rh1tech/echo_hdmi/3D/HDMI connector.STEP

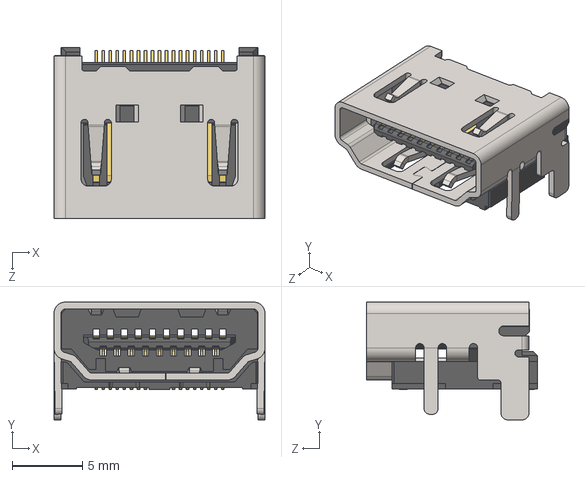
[picture p1: CAD file, 2025-07-04]
3D/HDMI connector.STEP
15.0 x 8.38 x 12.1 mm
