rh1tech/echo_hdmi/3D/PICO Clone-Black .step

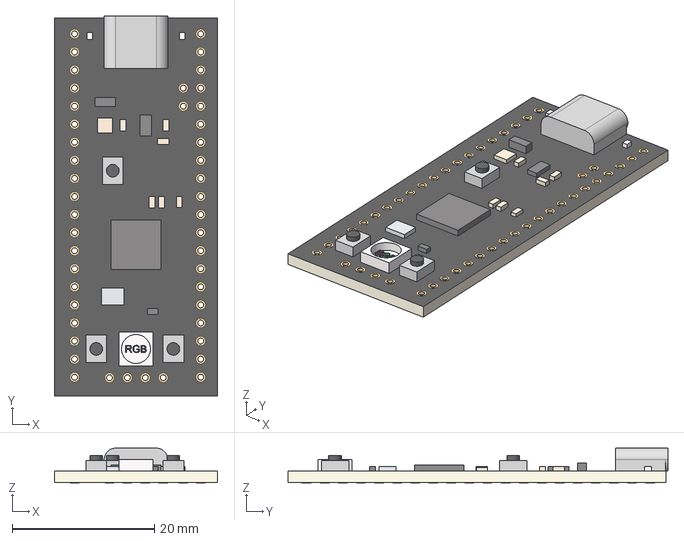
[picture p2: CAD file, 2025-07-04]
3D/PICO Clone-Black .step
22.9 x 53.3 x 4.88 mm
