rh1tech/echo_hdmi/3D/SJ1-3535NG.stp

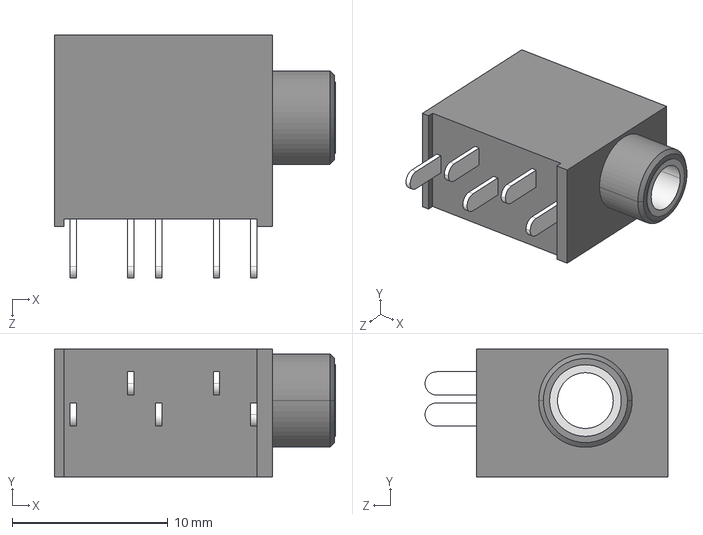
[picture p3: CAD file, 2025-07-04]
3D/SJ1-3535NG.stp
18.1 x 8.20 x 15.6 mm
