rh1tech/echo_hdmi/3D/ESP8266-12E_ESP-12E.step

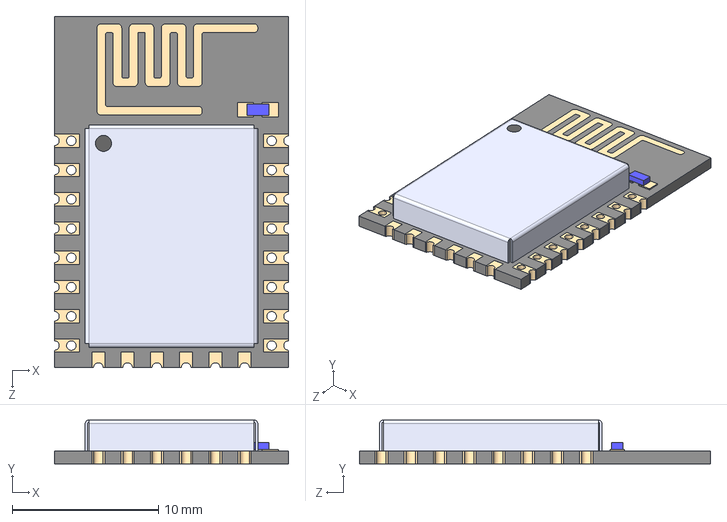
[picture p4: CAD file, 2025-07-04]
3D/ESP8266-12E_ESP-12E.step
16.0 x 3.00 x 24.0 mm
