rh1tech/echo_hdmi/3D/Mini-DIN-6P.step

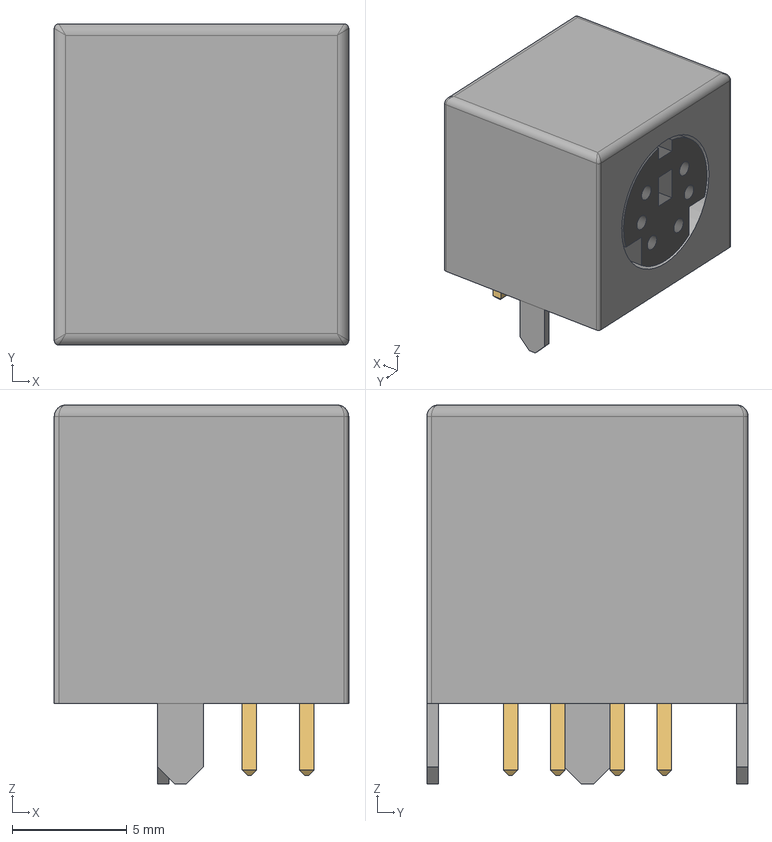
[picture p5: CAD file, 2025-07-04]
3D/Mini-DIN-6P.step
12.8 x 14.0 x 16.5 mm
