rh1tech/echo_hdmi/3D/Ts-1233_1.5.stp

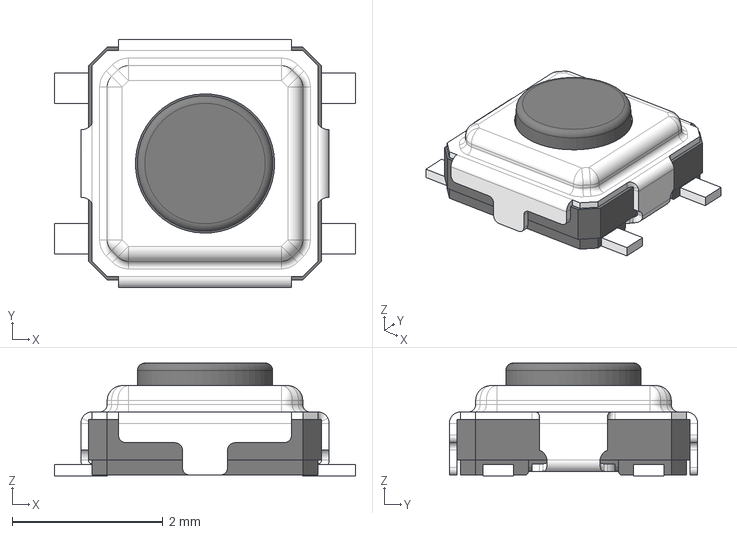
[picture p6: CAD file, 2025-07-04]
3D/Ts-1233_1.5.stp
4.00 x 3.30 x 1.50 mm
