rh1tech/echo_hdmi/3D/2520 SMD Crystal Oscillator.STEP

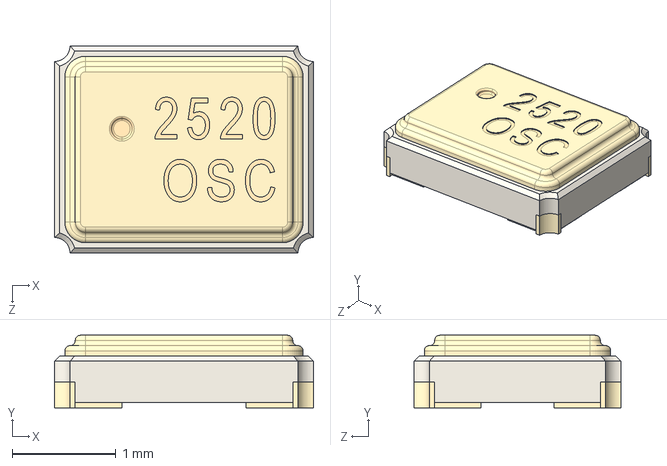
[picture p7: CAD file, 2025-07-04]
3D/2520 SMD Crystal Oscillator.STEP
2.50 x 0.7 x 2.00 mm
