rh1tech/echo_hdmi/3D/MAX232CSE+.stp

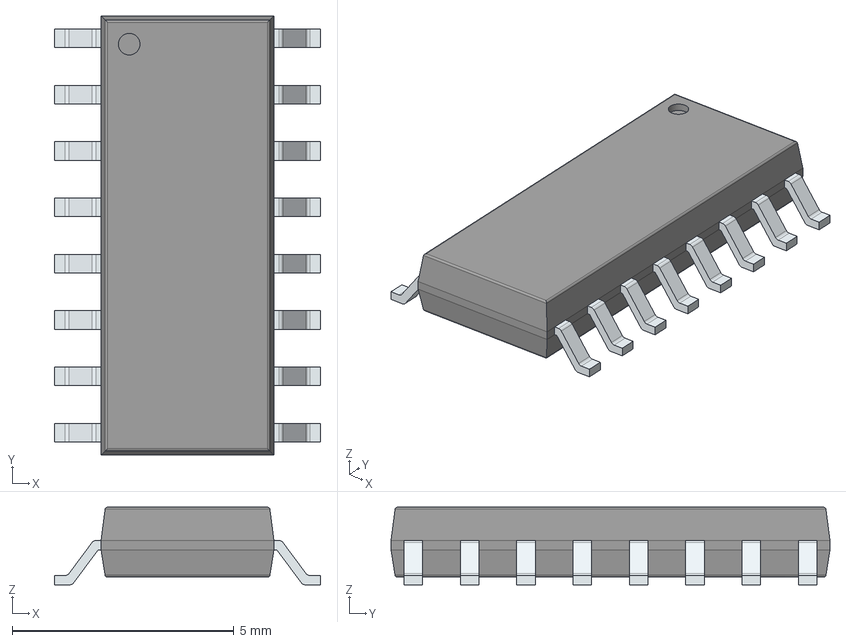
[picture p8: CAD file, 2025-07-04]
3D/MAX232CSE+.stp
6.00 x 9.90 x 1.75 mm
PinsArrayLR
