rh1tech/echo_hdmi/3D/User Library-QFN48_0_4.STEP

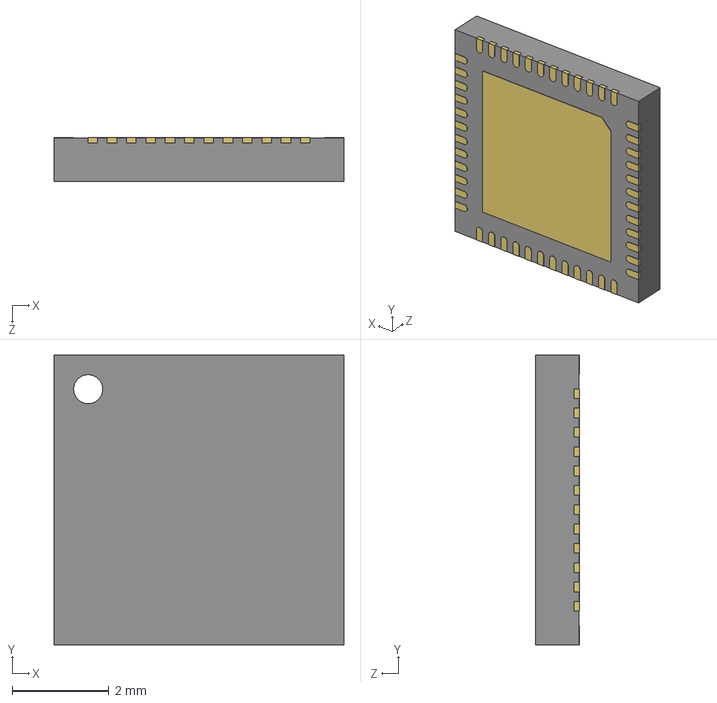
[picture p9: CAD file, 2025-07-04]
3D/User Library-QFN48_0_4.STEP
6.00 x 6.00 x 0.91 mm
