rh1tech/echo_hdmi/3D/SN74CBT3257CDR.step

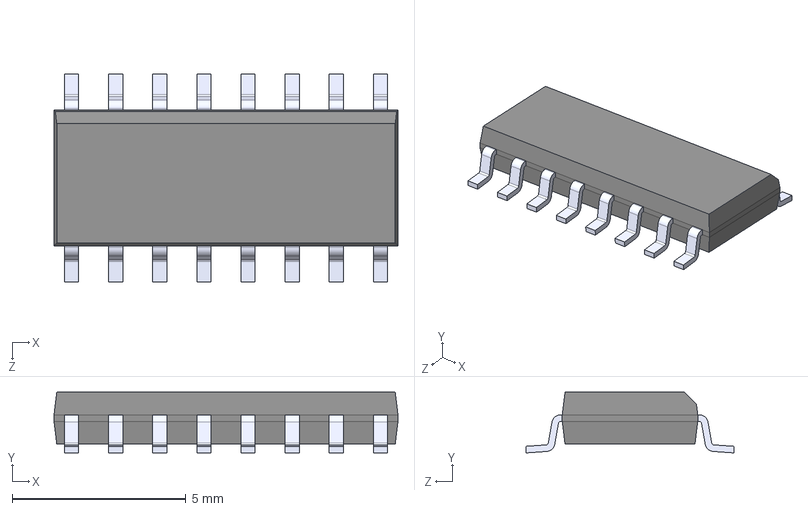
[picture p11: CAD file, 2025-07-04]
3D/SN74CBT3257CDR.step
9.90 x 1.75 x 6.00 mm
