rh1tech/echo_hdmi/3D/QFN48-5x5mm v3.step

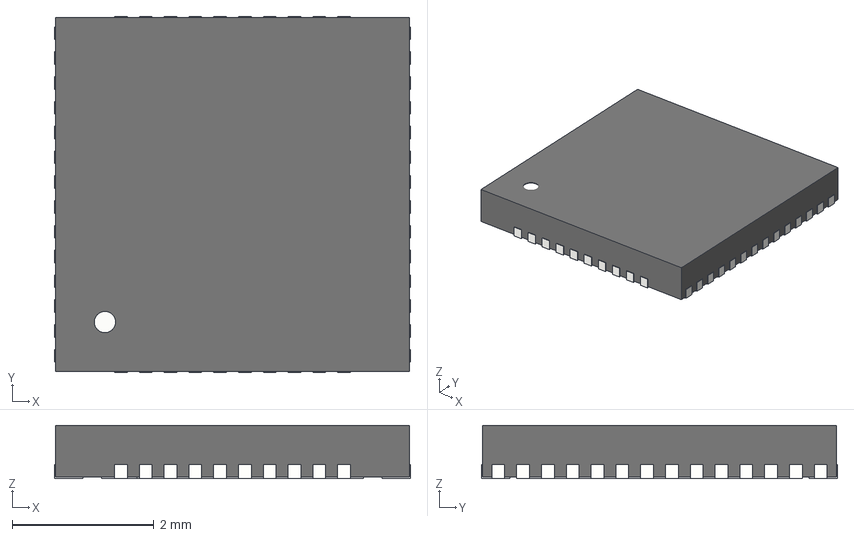
[picture p12: CAD file, 2025-07-04]
3D/QFN48-5x5mm v3.step
5.03 x 5.03 x 0.75 mm
Pads
