rh1tech/echo_hdmi/3D/raspberry pi pico with contacts.step

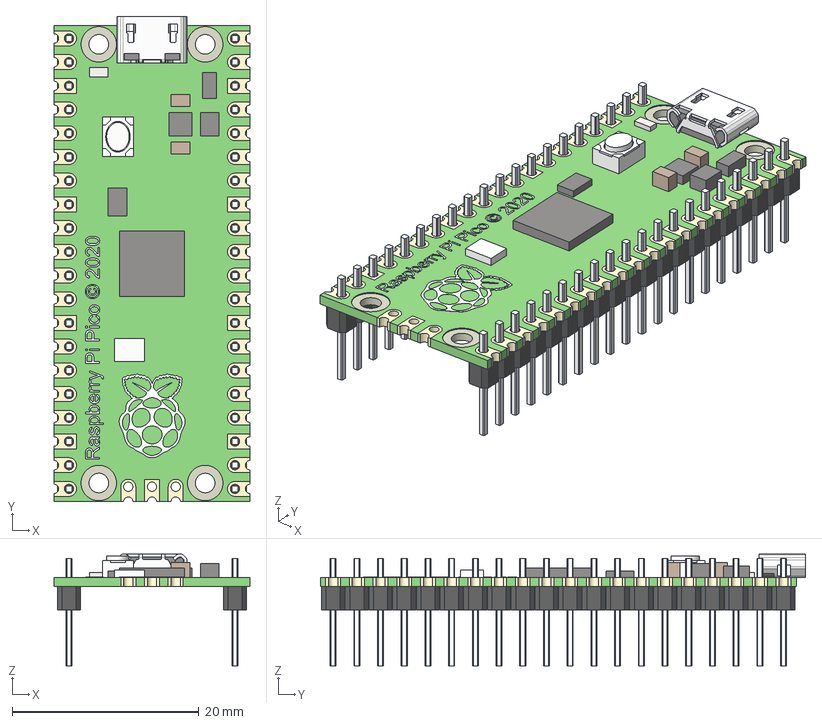
[picture p14: CAD file, 2025-07-04]
3D/raspberry pi pico with contacts.step
21.0 x 52.0 x 12.0 mm
ножка x 20
ножка v3(Mirror) x 20
