rh1tech/echo_hdmi/3D/QFN-48_7x7.step

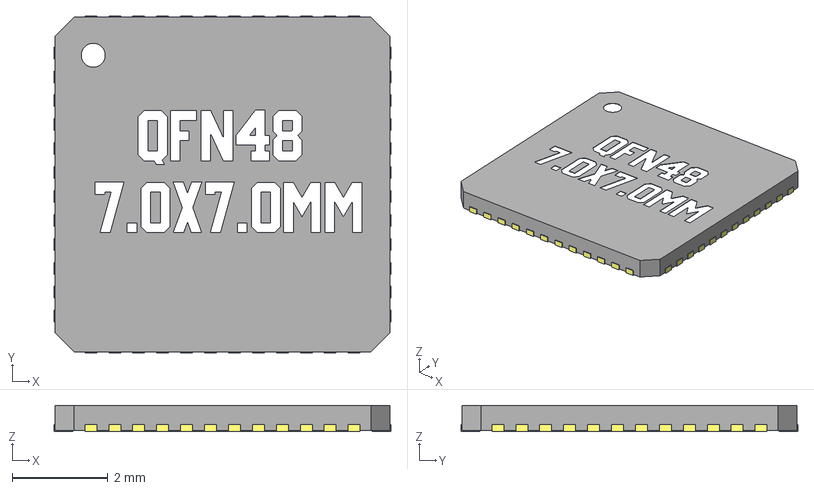
[picture p15: CAD file, 2025-07-04]
3D/QFN-48_7x7.step
7.04 x 7.04 x 0.55 mm
TxT
