rh1tech/echo_hdmi/3D/DS05-127-2-03BK-SMT-TR.step

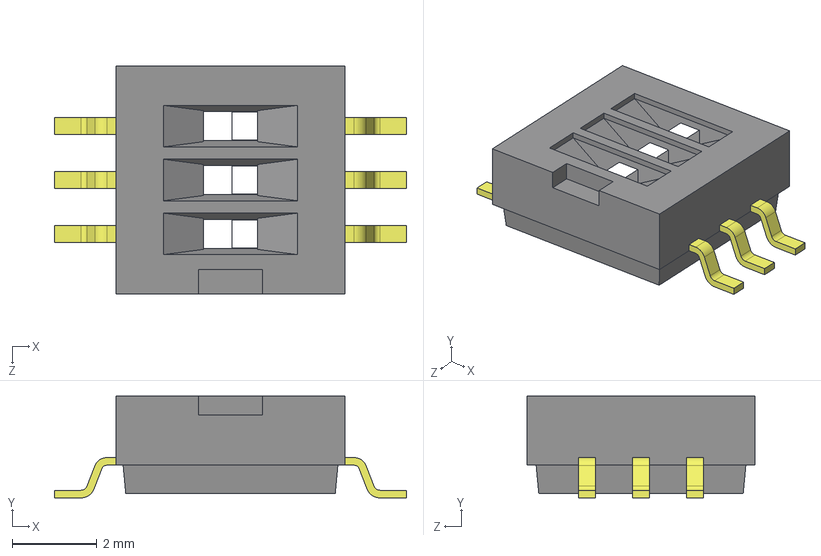
[picture p18: CAD file, 2025-07-04]
3D/DS05-127-2-03BK-SMT-TR.step
8.30 x 2.40 x 5.38 mm
