rh1tech/echo_hdmi/3D/1TS003B.step

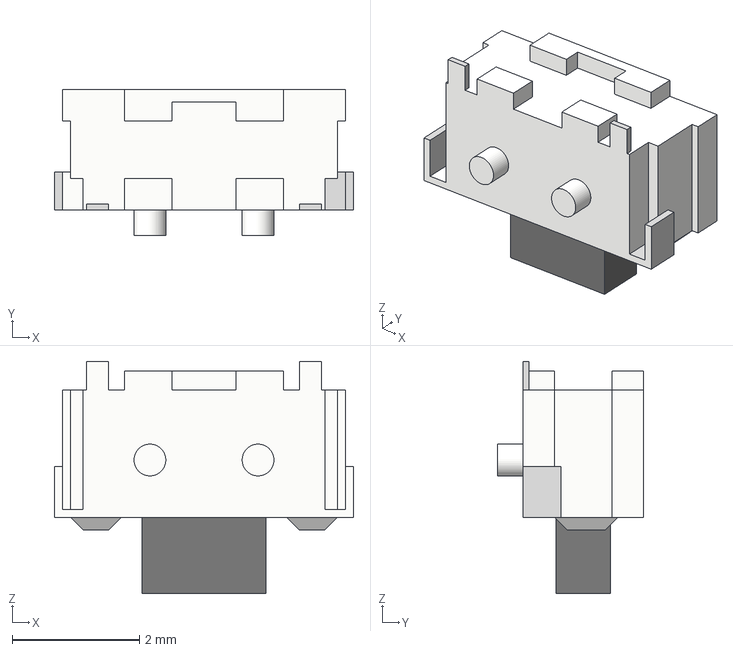
[picture p20: CAD file, 2025-07-04]
3D/1TS003B.step
4.70 x 2.30 x 3.65 mm
