rh1tech/echo_hdmi/3D/USB1035-GF-P-0-B-B.stp

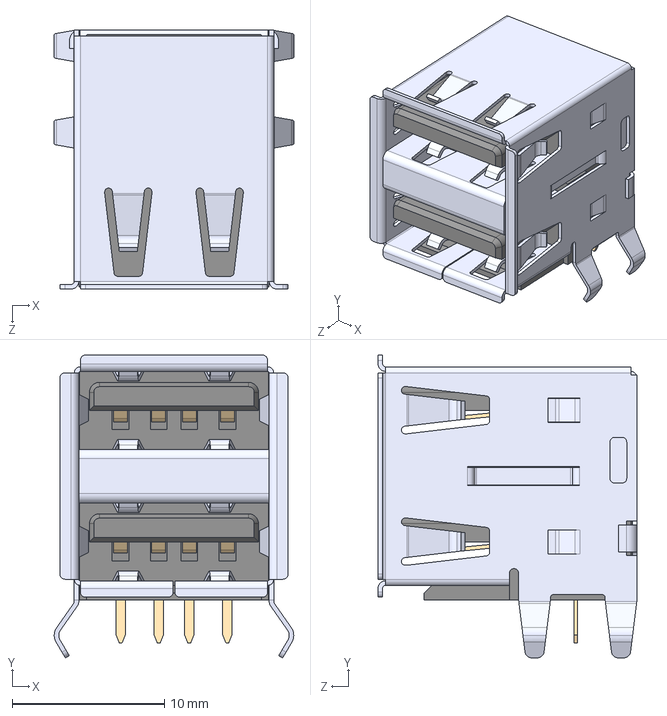
[picture p26: CAD file, 2025-07-04]
3D/USB1035-GF-P-0-B-B.stp
15.7 x 19.9 x 17.0 mm
