rh1tech/echo_hdmi/(list of files, cad)

Other CAD files:
3D/47571-0001.stp
