rh1tech/echo_hdmi/DOCS/1_00/assembly.pdf

# RP RESET P/U AUDIO OUT

# ESP RESET ESP CTRL H/B

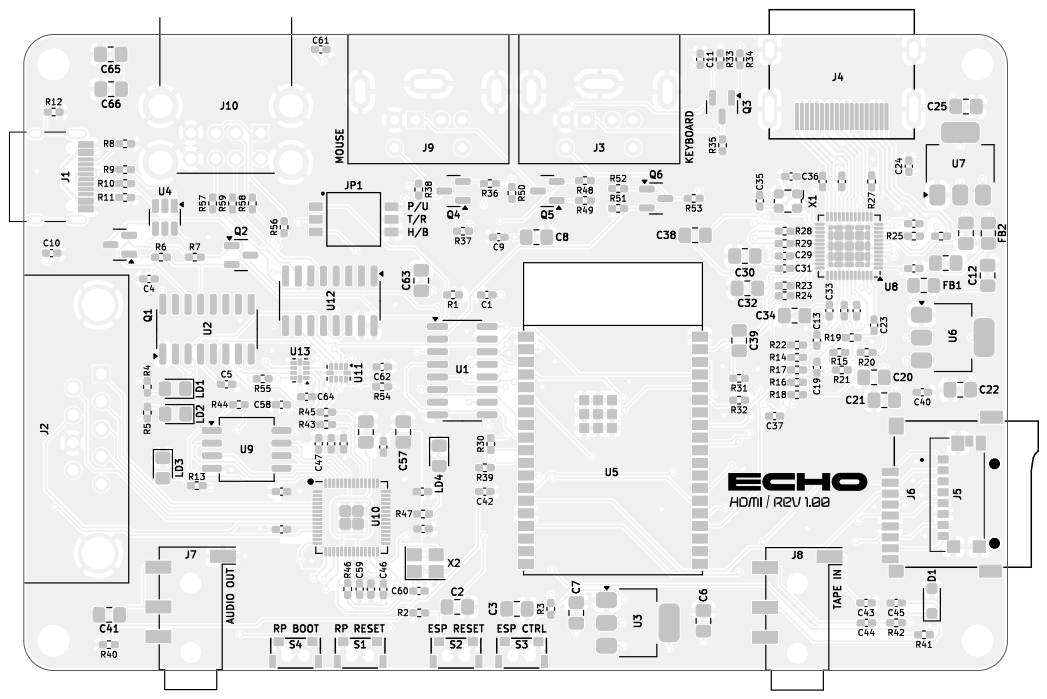
[picture p28: page 1]

https://github.com/rh1tech/echo Black And White TOP - Page 1/4

Id: /1 Title: Echo HDMI File: echo.kicad_pcb Sheet: Black And White TOP Mikhail Matveev

## TP2 TP1

JP2 1 | 2 | 3 | 4 | 5 | 6

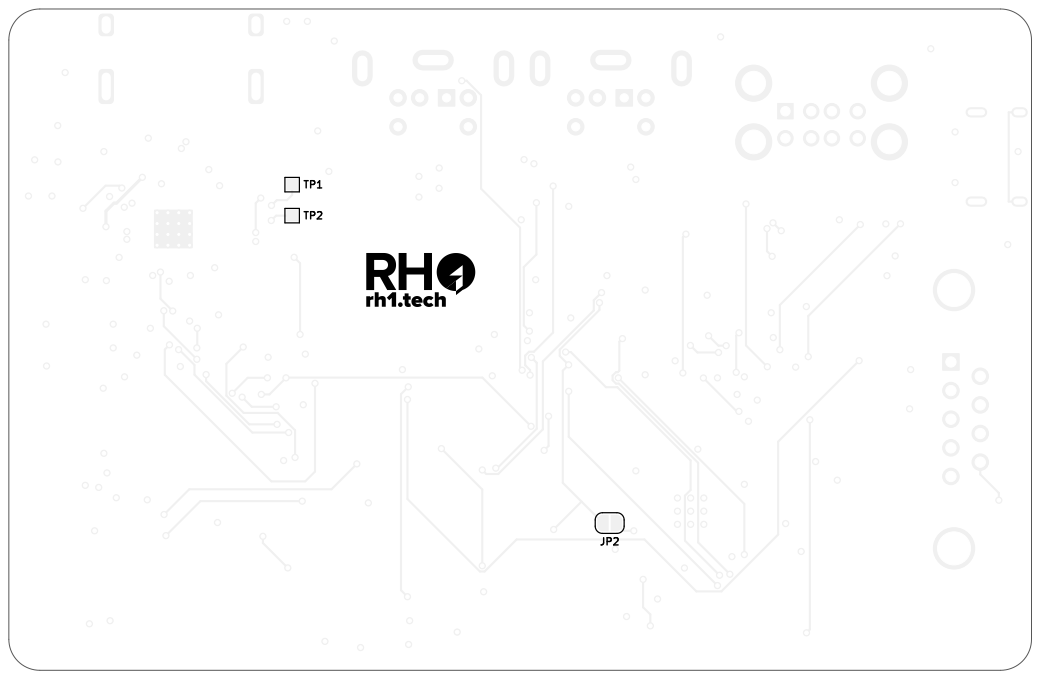
[picture p29: page 2]
D Date: 2025-07-04 KiCad; E.D.A. 9.0.0 Size: A4; Rev: 1.00; Id: /1 Title: Echo HDMI File: echo.kicad_pcb Sheet: Black; And; White; BOT Mikhail; Matveev; https://github.com/rh1tech/echo Black; BOT -; Page 2/4

A

A

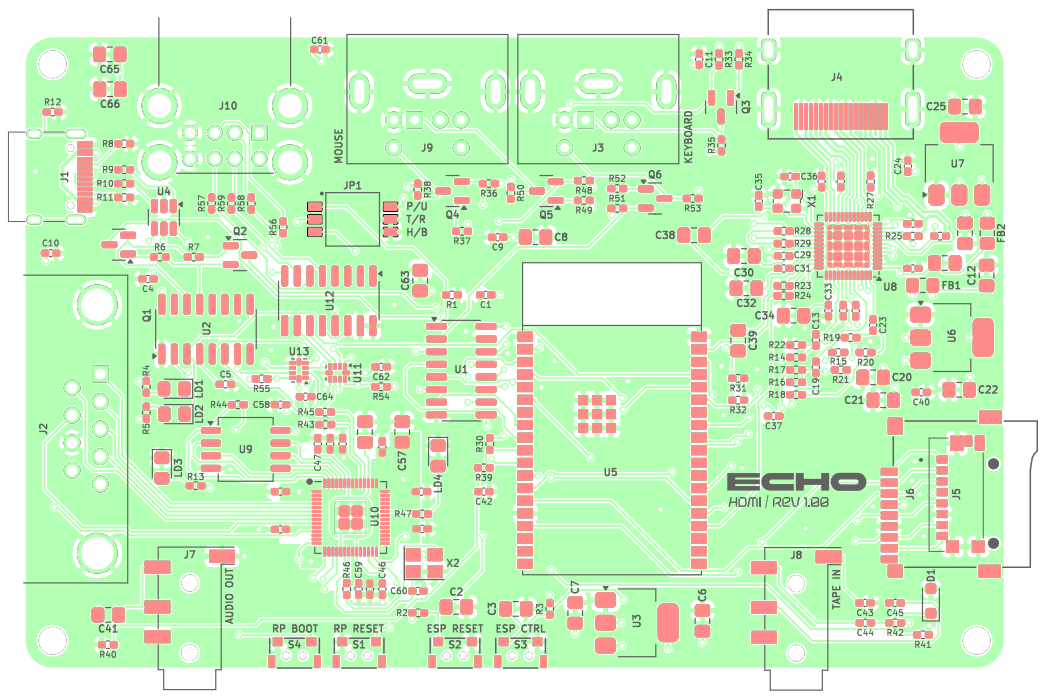
[picture p30: page 3]

ESP RESET ESP CTRL H/B

## TP2 TP1

JP2 1 | 2 | 3 | 4 | 5 | 6

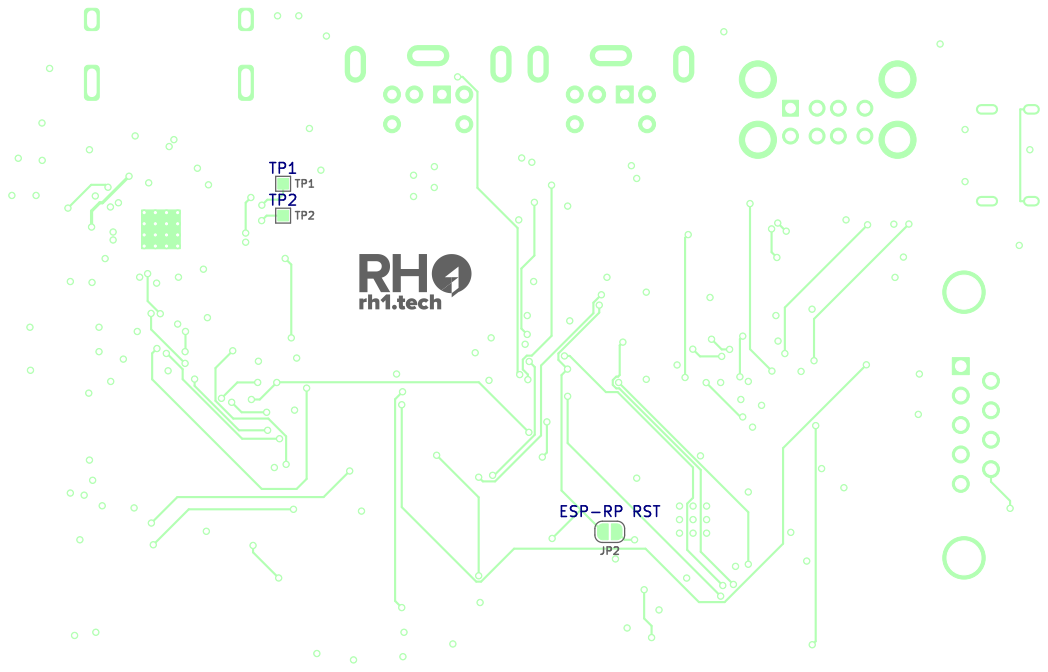
[picture p31: page 4]
D Date: 2025-07-04 KiCad; E.D.A. 9.0.0 Size: A4; Rev: 1.00; Id: /1 Title: Echo HDMI File: echo.kicad_pcb Sheet: Colored; BOT Mikhail; Matveev; https://github.com/rh1tech/echo Colored; BOT -; Page 4/4; ESP-RP RST
