rh1tech/echo_hdmi/DOCS/1_00/echo.pdf

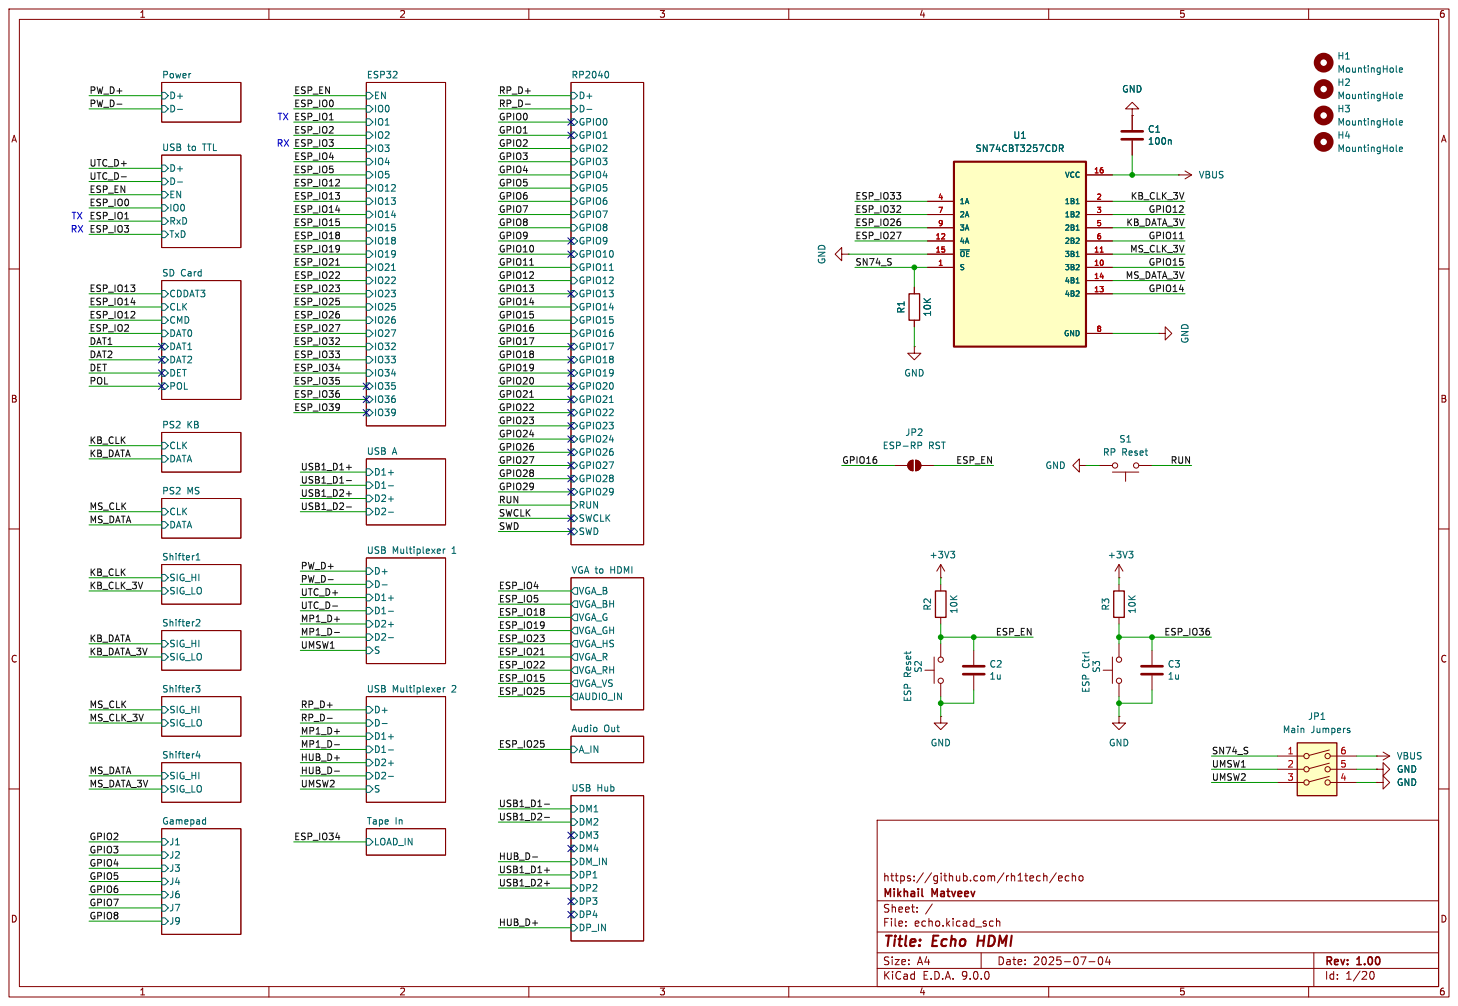
[picture p32: page 1]

TXRX RX
DAT0 DAT1 DAT2 DET POL SD Card D+D- EN

https://github.com/rh1tech/echo

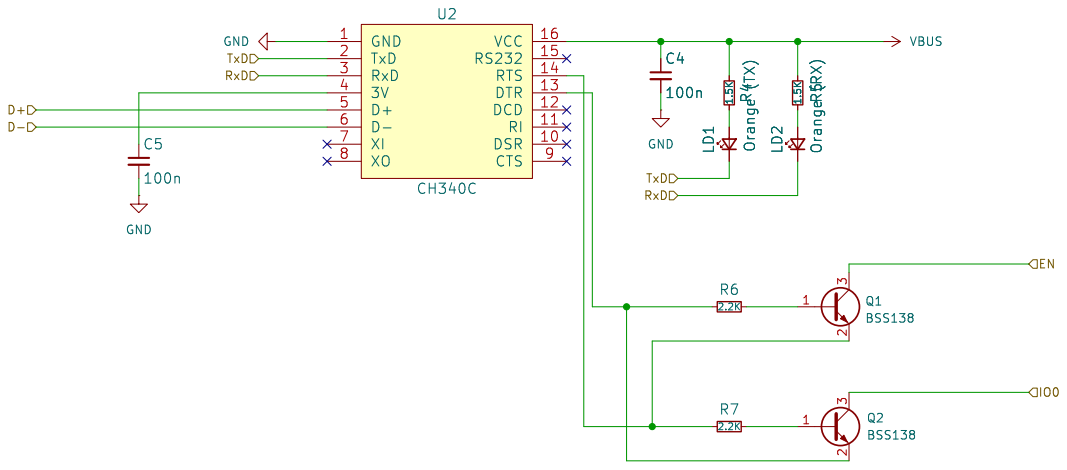
[picture p33: page 2]

https://github.com/rh1tech/echo

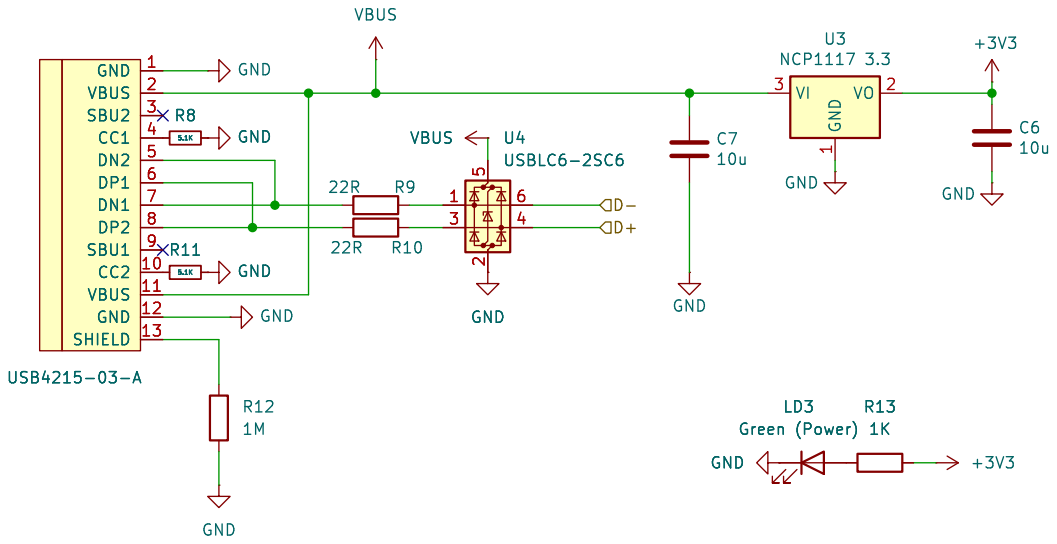
[picture p34: page 3]

1 VO 2 U3 NCP1117 3.3 GND GND 1 VBUS 2 SBU2 3 CC1 4 DN2 5 DP1 6 DN1 7 DP2 8 SBU1 9 CC2 10 VBUS 11 GND 12 SHIELD 13 USB4215-03-A GND

https://github.com/rh1tech/echo GND GND

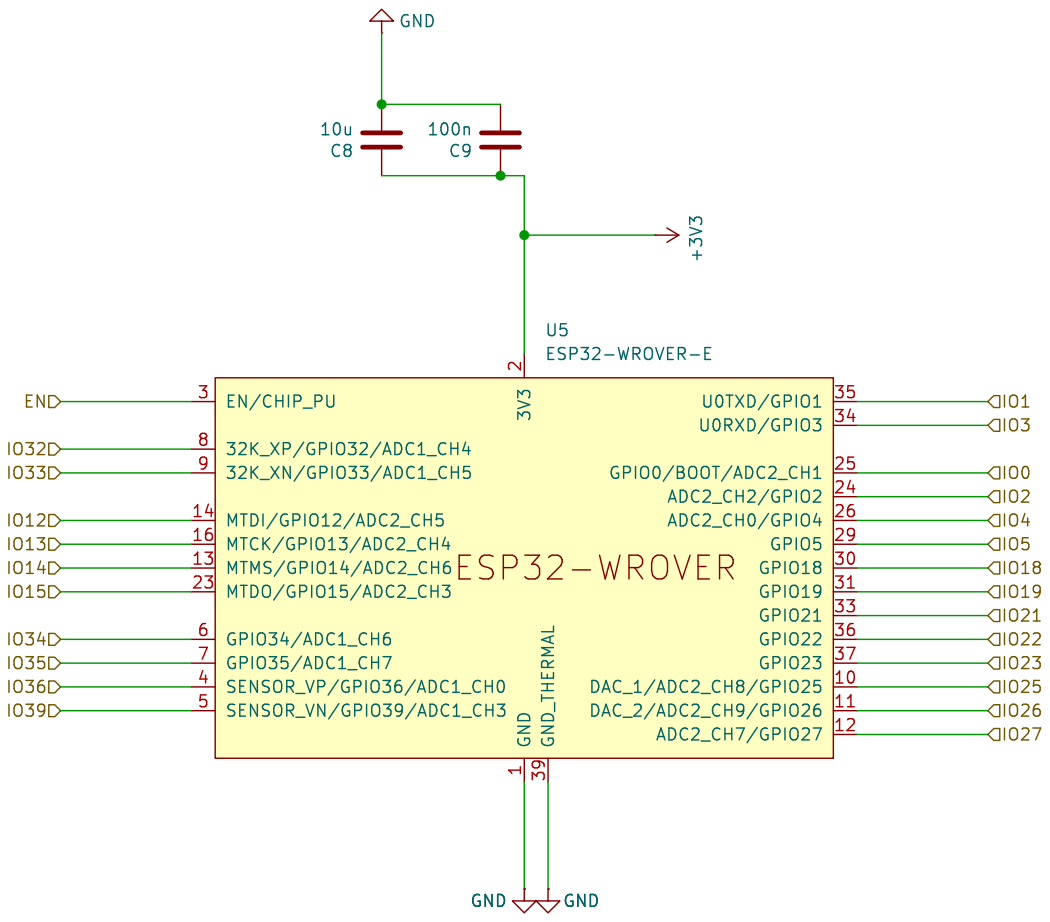
[picture p35: page 4]

1 GND_THERMAL 39 U0TXD/GPIO1 35 U0RXD/GPIO3 34 GPIO0/BOOT/ADC2_CH1 25 ADC2_CH2/GPIO2 24 ADC2_CH0/GPIO4 26 GPIO5 29 GPIO18 30 GPIO19 31 GPIO21 33 GPIO22 36 GPIO23 37 DAC_1/ADC2_CH8/GPIO25 10 DAC_2/ADC2_CH9/GPIO26 11 ADC2_CH7/GPIO27 12 U5ESP32-WROVER-E GND GND GND

https://github.com/rh1tech/echo

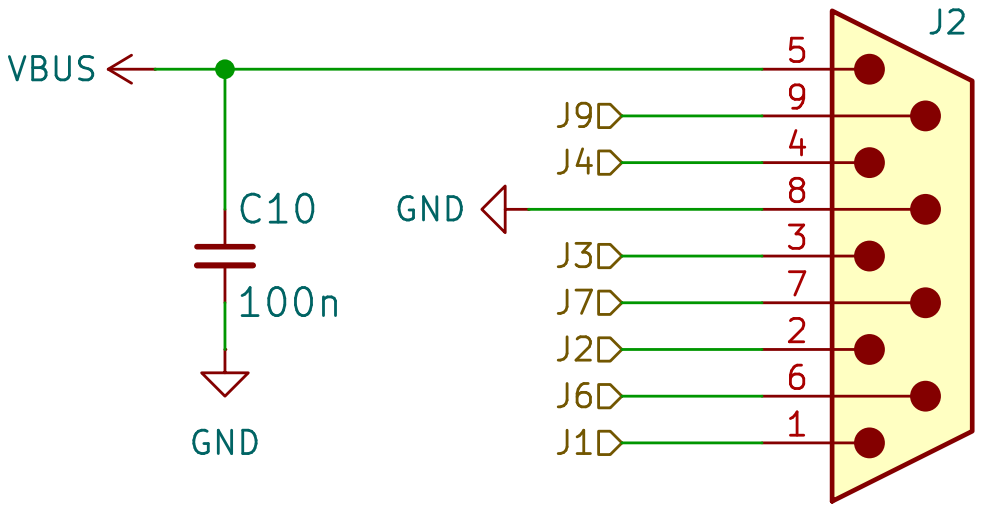
[picture p36: page 5]

https://github.com/rh1tech/echo

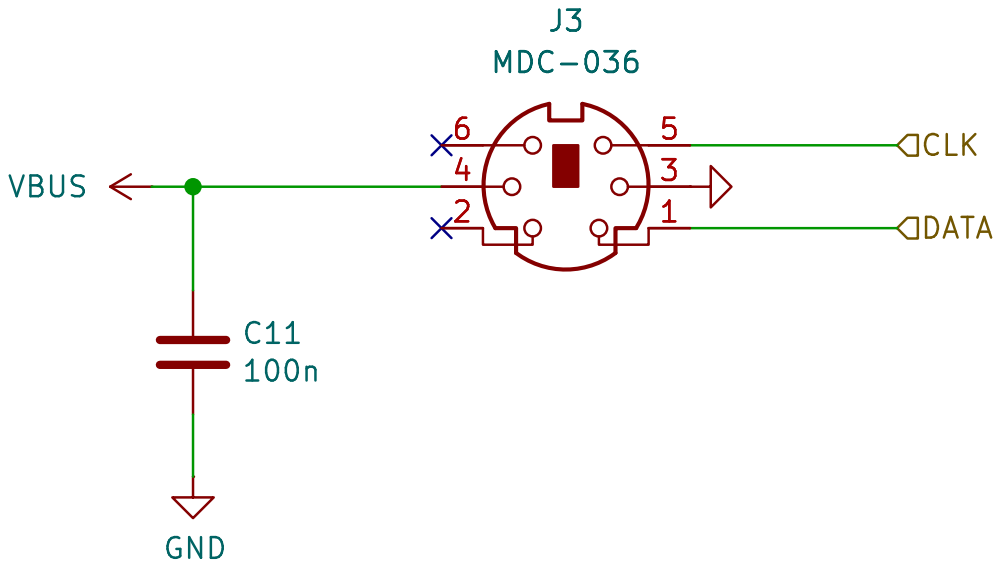
[picture p37: page 6]

https://github.com/rh1tech/echo

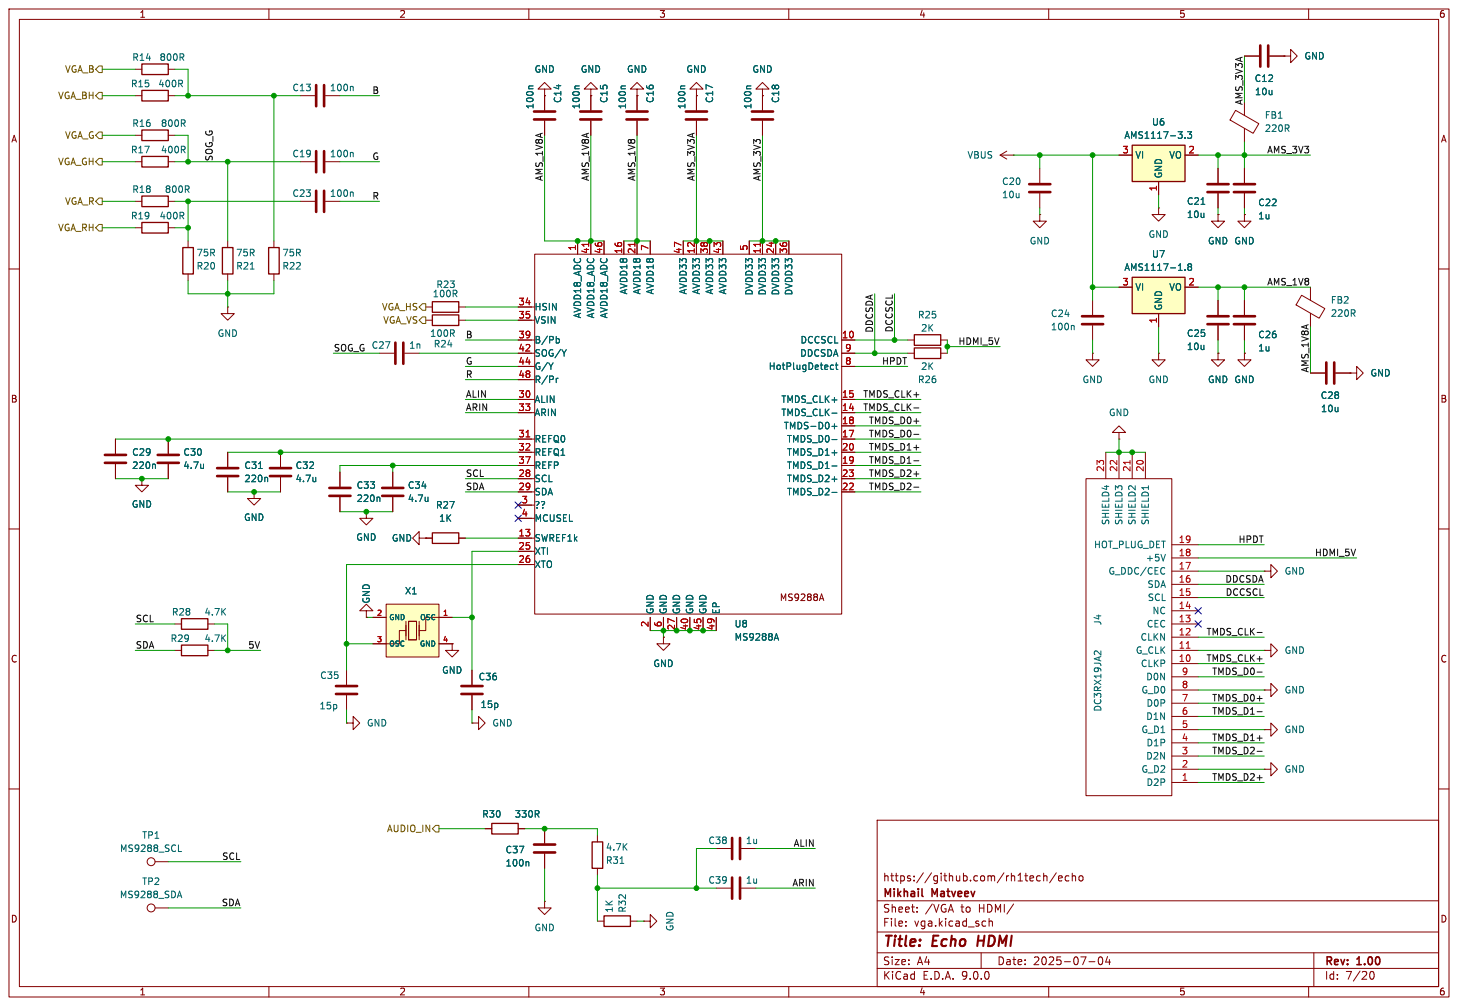
[picture p38: page 7]

5 DVDD33 11 DVDD33 24 DVDD33 36 DCCSCL 10 DDCSDA 9 HotPlugDetect 8 TMDS_CLK+ 15 TMDS_CLK- 14 TMDS-D0+ 18 TMDS_D0- 17 TMDS_D1+ 20 TMDS_D1- 19 TMDS_D2+ 23 TMDS_D2- 22 U8 MS9288A GND GND C36

5 DVDD33 11 DVDD33 24 DVDD33 36 DCCSCL 10 DDCSDA 9 HotPlugDetect 8 TMDS_CLK+ 15 TMDS_CLK- 14 TMDS-D0+ 18 TMDS_D0- 17 TMDS_D1+ 20 TMDS_D1- 19 TMDS_D2+ 23 TMDS_D2- 22 GND C36

6 GND 27 AVDD33 47 GND 40 AVDD33 12 GND 45 AVDD33 38 EP 49 AVDD33 43 DVDD33

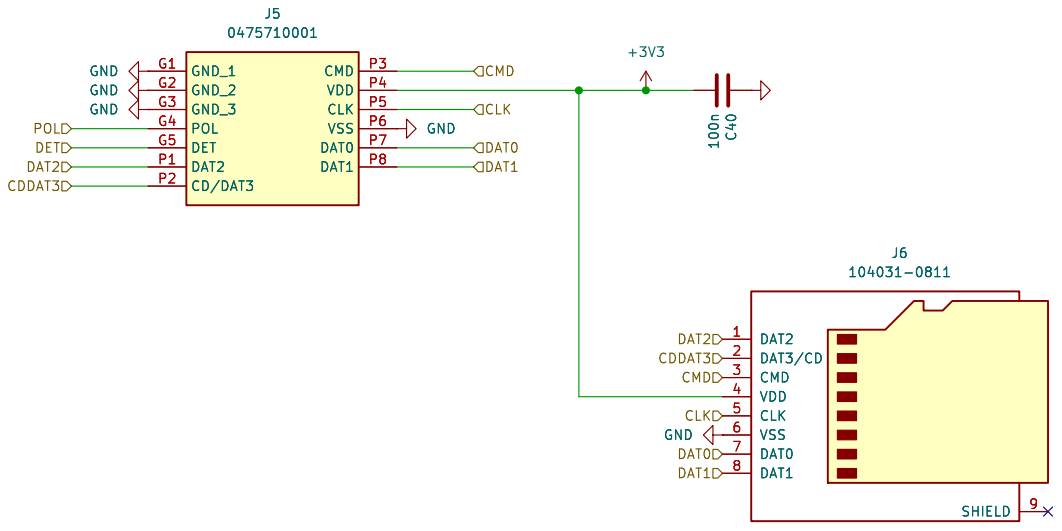
[picture p39: page 8]

https://github.com/rh1tech/echo GND

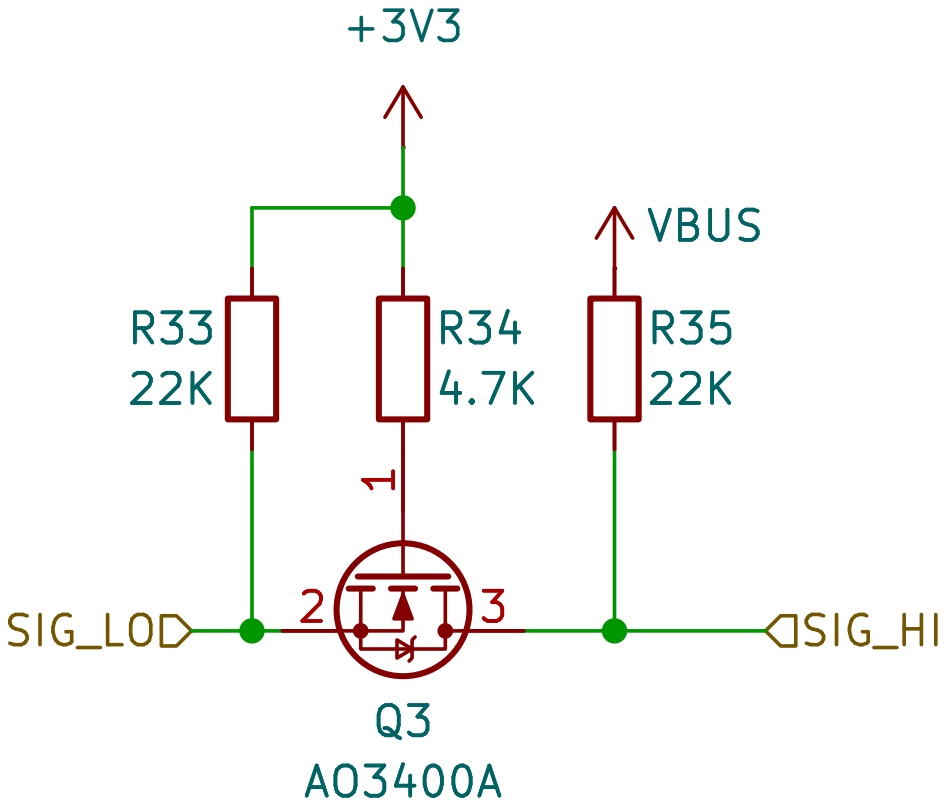
[picture p40: page 9]

https://github.com/rh1tech/echo R35

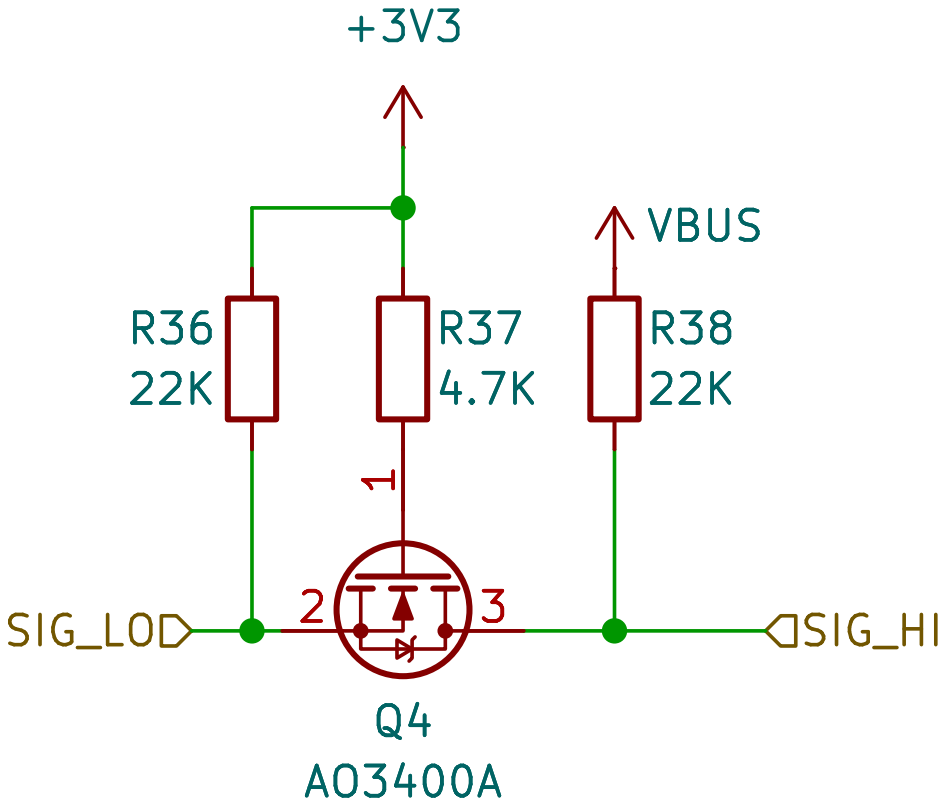
[picture p41: page 10]

https://github.com/rh1tech/echo R38

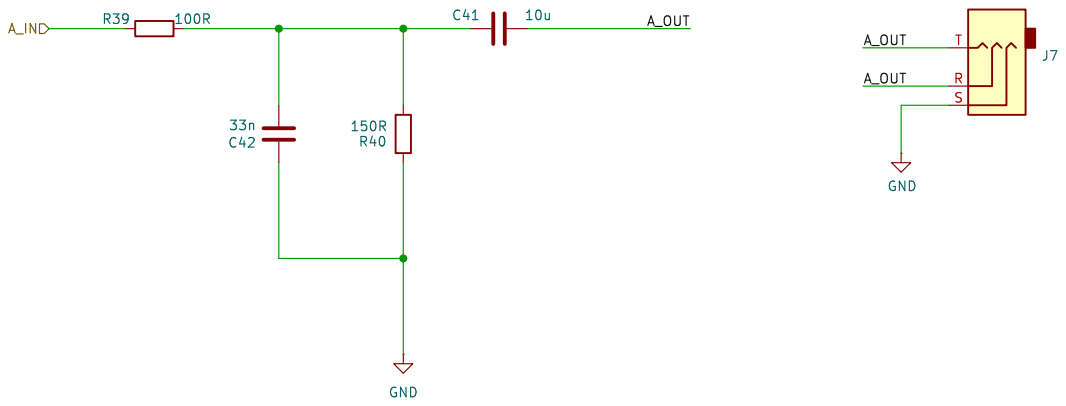
[picture p42: page 11]

https://github.com/rh1tech/echo GND

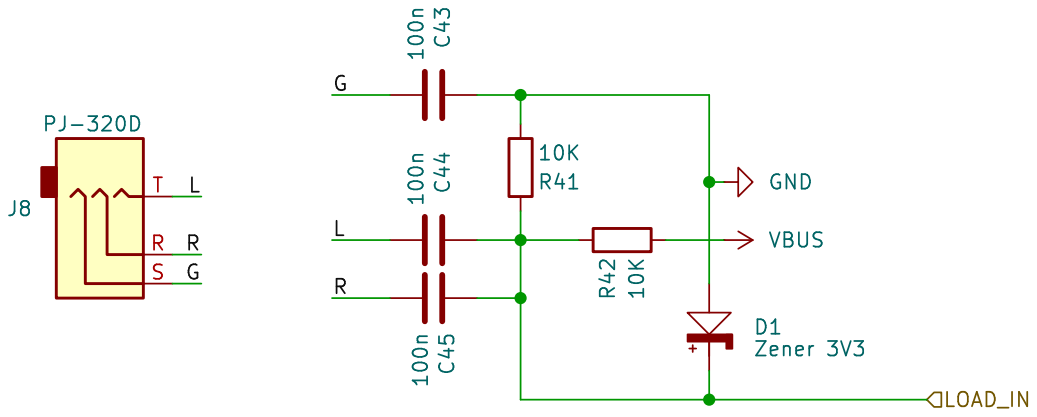
[picture p43: page 12]

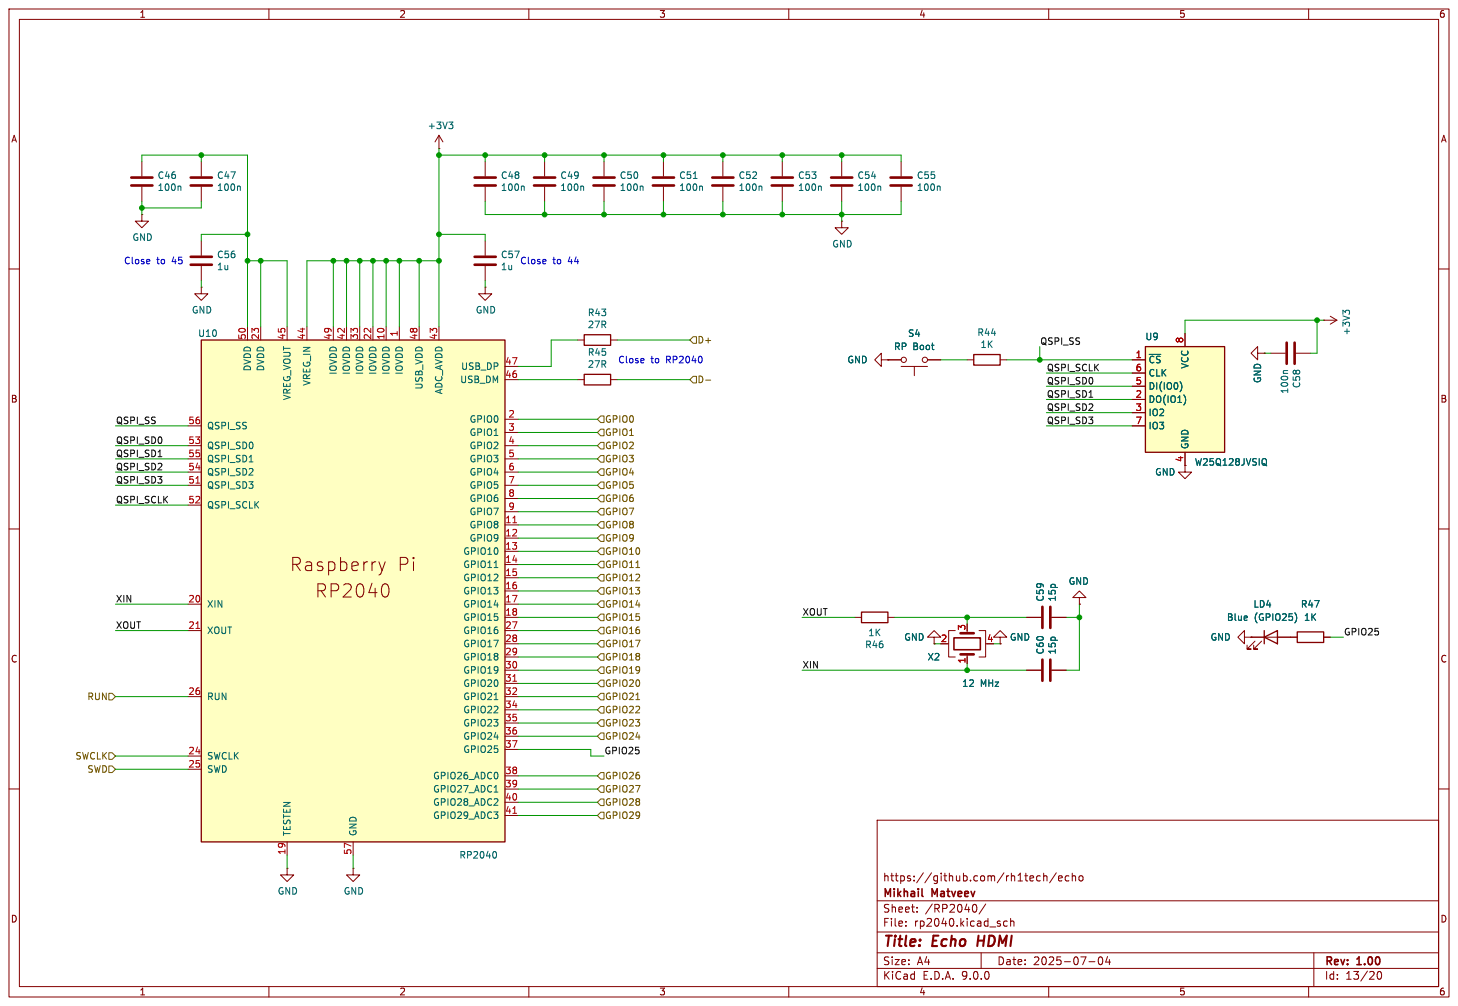
[picture p44: page 13]

https://github.com/rh1tech/echo GND

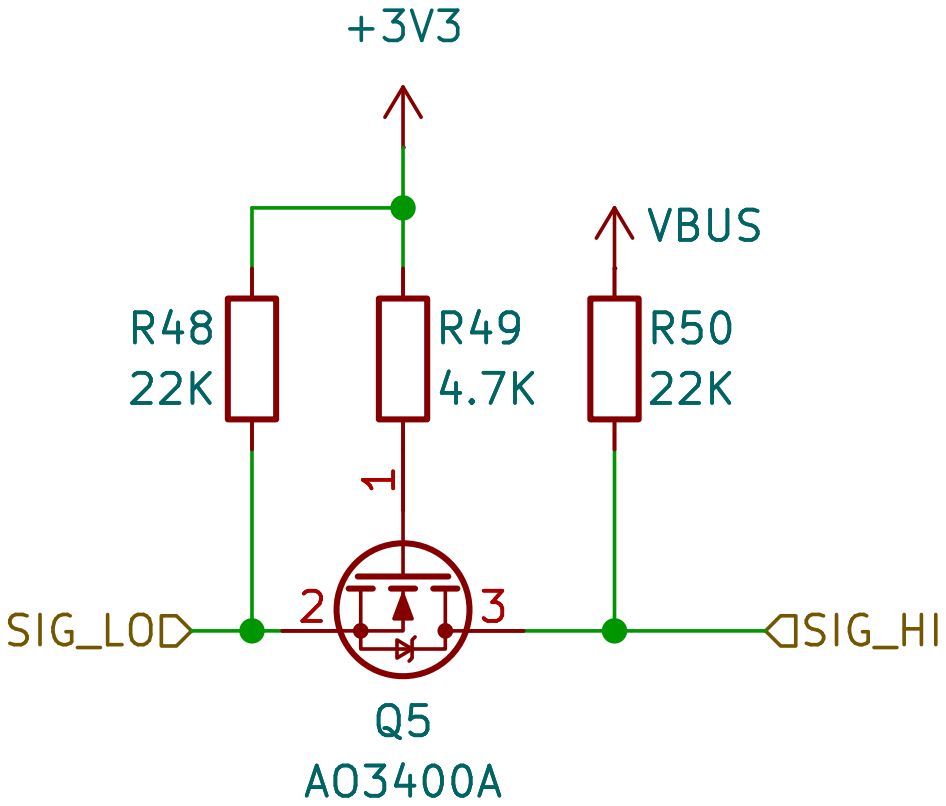
[picture p45: page 14]

https://github.com/rh1tech/echo R50

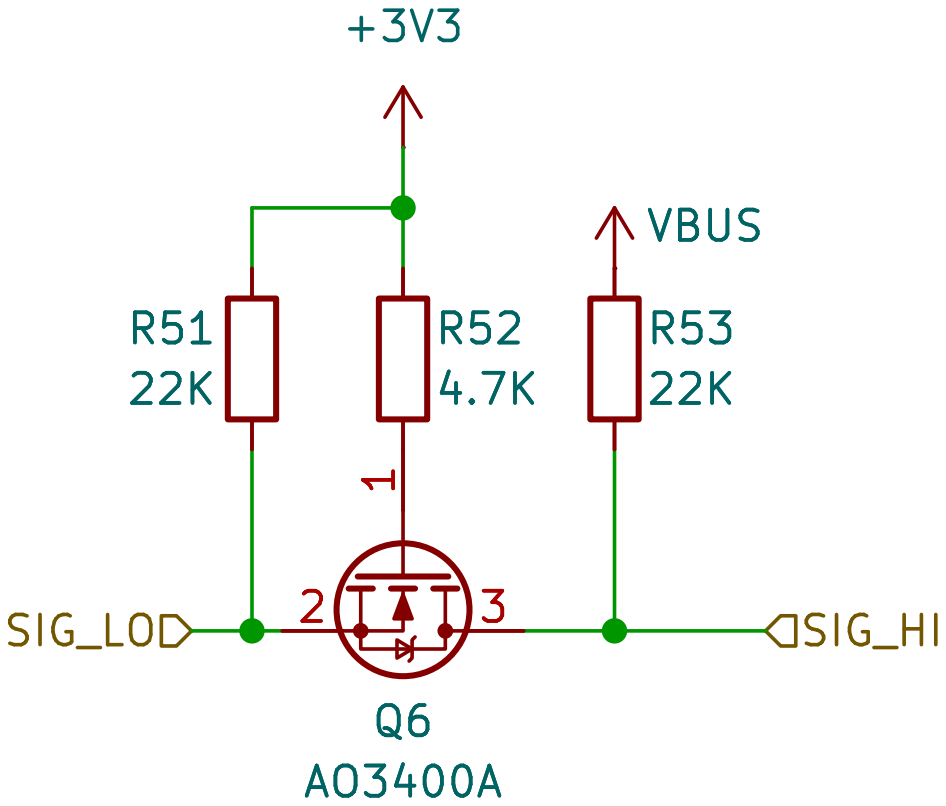
[picture p46: page 15]

https://github.com/rh1tech/echo R53

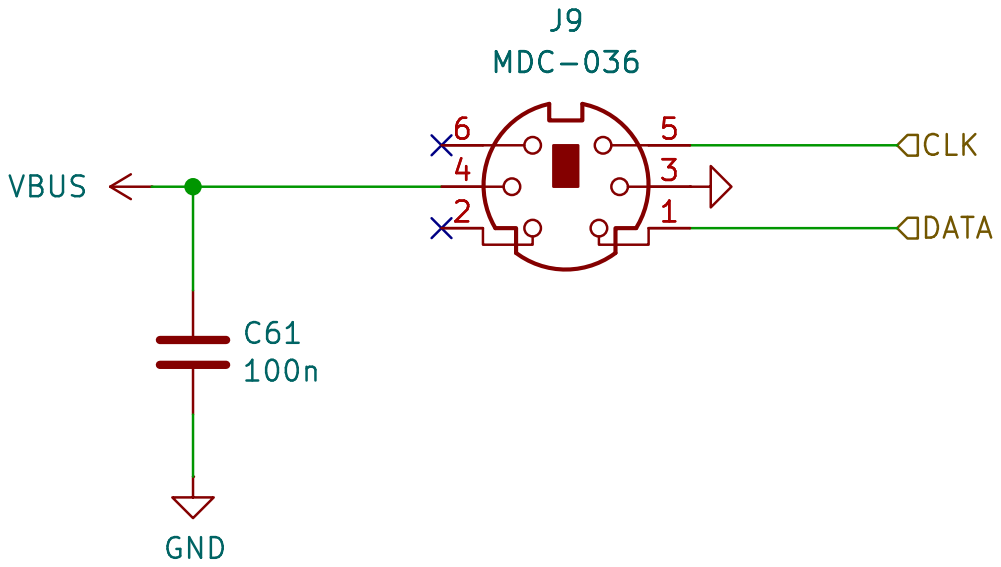
[picture p47: page 16]

https://github.com/rh1tech/echo

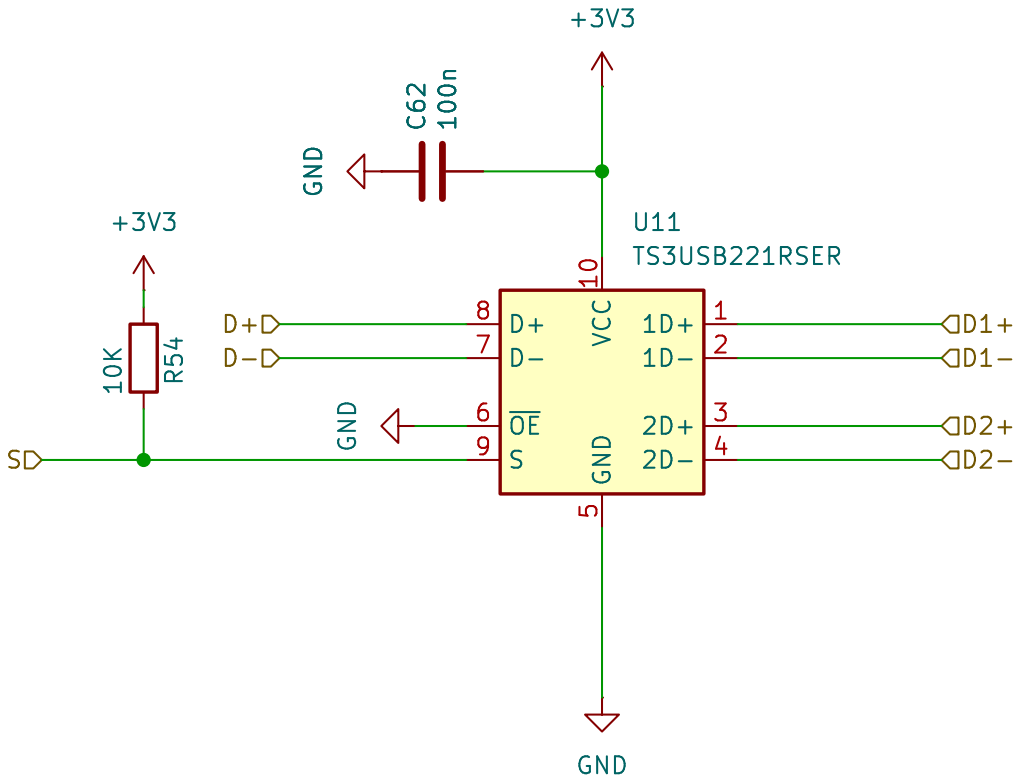
[picture p48: page 17]

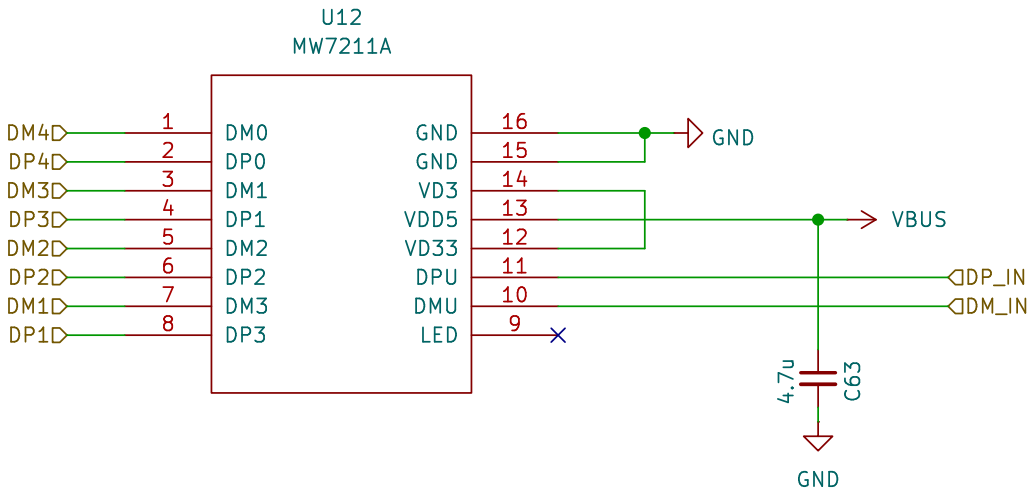
[picture p49: page 18]

https://github.com/rh1tech/echo

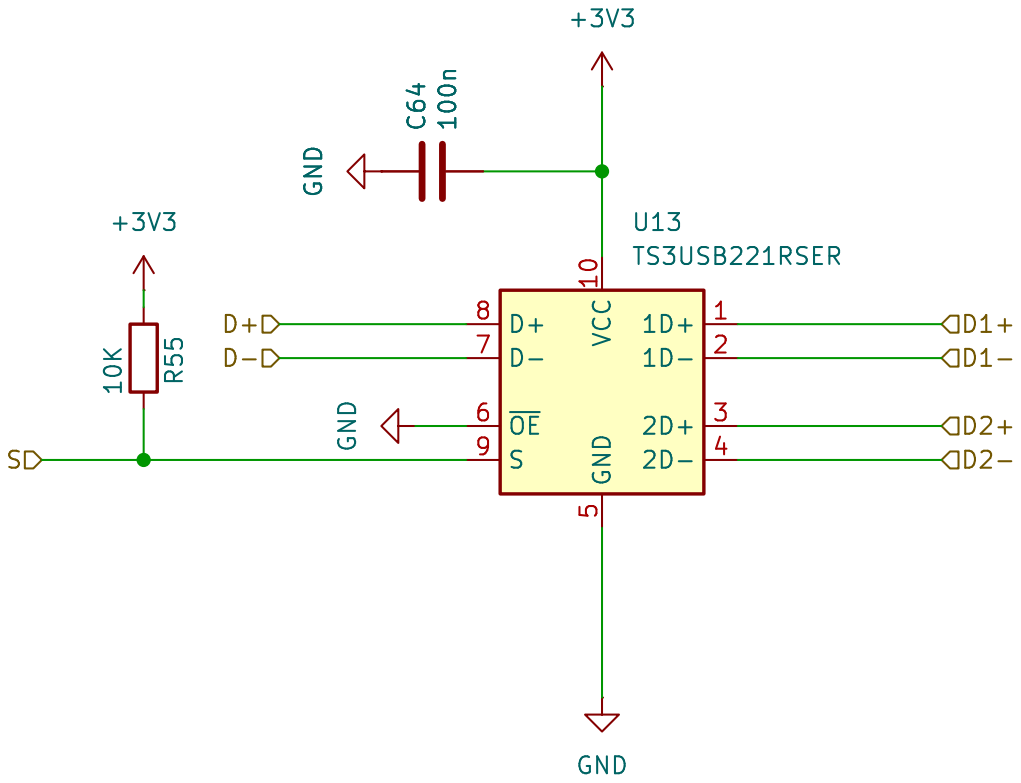
[picture p50: page 19]

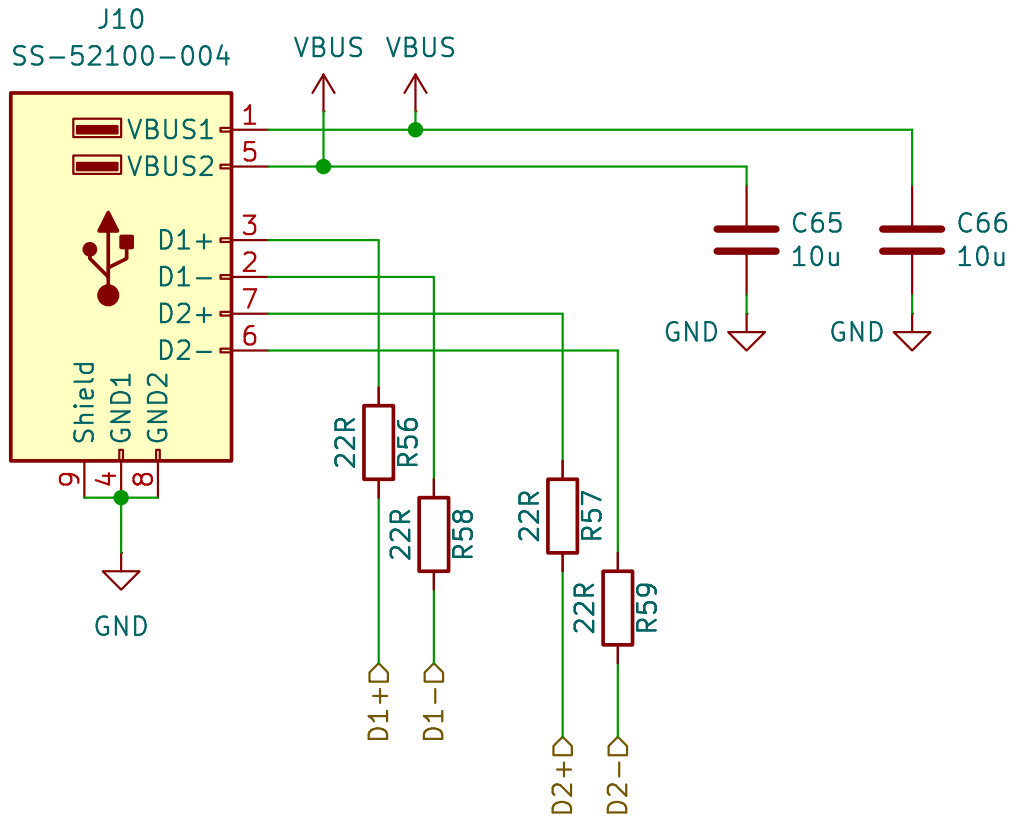
[picture p51: page 20]
