rh1tech/echo_hdmi/echo.kicad_pcb

## KiCad design echo.kicad_pcb (2025-07-04)

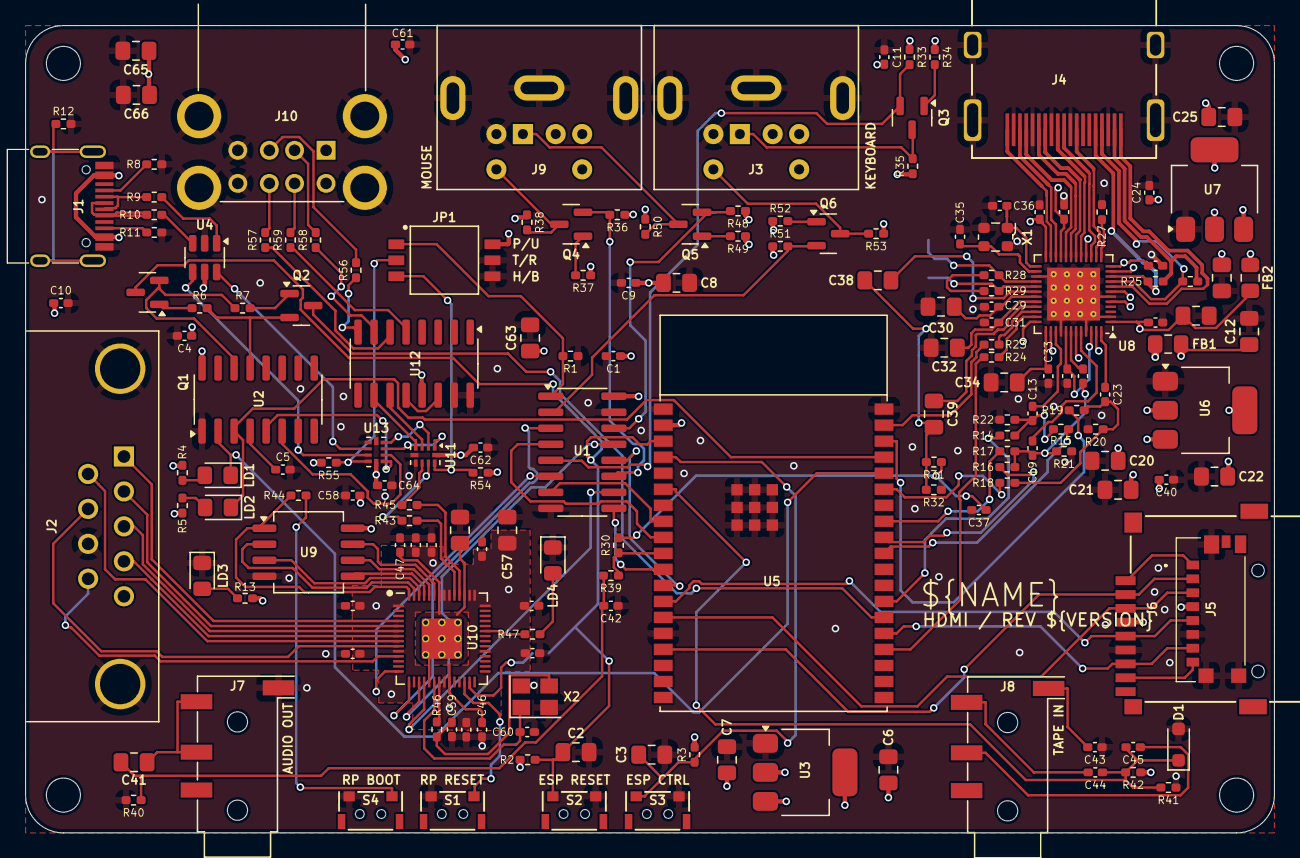
[picture p52: board echo.kicad_pcb from above]

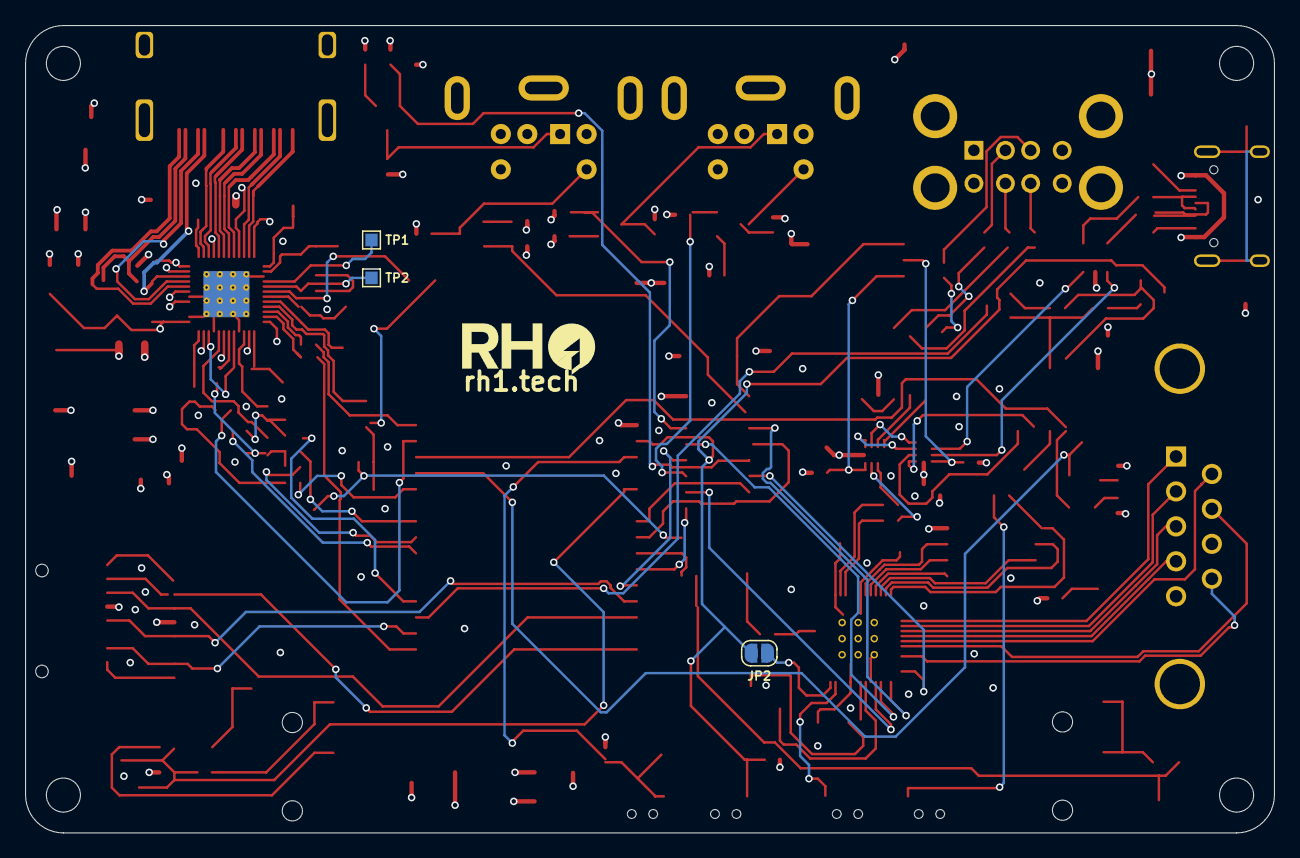
[picture p53: board echo.kicad_pcb from below]

Board: 4 copper layers, 99.0 x 64.0 mm, 175 parts (3 on the bottom side), 148 nets.

Parts:
C1, C4, C5, C9, C10, C11, C13, C14, C15, C16, C17, C18, C19, C23, C24, C37, C40, C43, C44, C45, C46, C47, C48, C49, C50, C51, C52, C53, C54, C55, C58, C61, C62, C64: 100n; Capacitor (0402)
C2, C3, C22, C26, C38, C39, C56, C57: 1u; Capacitor (0805)
C6, C7, C8, C12, C20, C21, C25, C28, C41, C65, C66: 10u; Capacitor (0805)
C27: 1n; Capacitor (0402)
C29, C31, C33: 220n; Capacitor (0402)
C30, C32, C34, C63: 4.7u; Capacitor (0805)
C35, C36, C59, C60: 15p; Capacitor (0402)
C42: 33n; Capacitor (0402)
D1: Zener 3V3; Diode (SOD-323)
FB1, FB2: 220R; Inductor (0805)
H1, H2, H3, H4: MountingHole; Mounting Hole (2.7mm)
J1: USB4215-03-A; USB Type C
J2: D-SUB 9 Male; D-SUB (9 pin, male, top mount)
J3, J9: MDC-036; MiniDIN (6 Pin, female)
J4: DC3RX19JA2; HDMI (female)
J5: 0475710001; MicroSD (SMD, short)
J6: 104031-0811; MicroSD (SMD, long)
J7, J8: PJ-320D; Jack (3.5mm, PJ-320D)
J10: SS-52100-004; USB Type A (stacked)
JP1: Main Jumpers; SW_DS05-127-2-03BK-SMT-TR
JP2: ESP-RP RST; Jumper (solder)
LD1: Orange (TX); LED (0805)
LD2: Orange (RX); LED (0805)
LD3: Green (Power); LED (0805)
LD4: Blue (GPIO25); LED (0805)
Q1, Q2: BSS138; SOT-23
Q3, Q4, Q5, Q6: AO3400A; SOT-23
R1, R2, R3, R41, R42, R54, R55: 10K; Resistor (0402)
R4, R5: 1.5K; Resistor (0402)
R6, R7: 2.2K; Resistor (0402)
R8, R11: 5.1K; Resistor (0402)
R9, R10, R56, R57, R58, R59: 22R; Resistor (0402)
R12: 1M; Resistor (0402)
R13, R27, R32, R44, R46, R47: 1K; Resistor (0402)
R14, R16, R18: 800R; Resistor (0402)
R15, R17, R19: 400R; Resistor (0402)
R20, R21, R22: 75R; Resistor (0402)
R23, R24, R39: 100R; Resistor (0402)
R25, R26: 2K; Resistor (0402)
R28, R29, R31, R34, R37, R49, R52: 4.7K; Resistor (0402)
R30: 330R; Resistor (0402)
R33, R35, R36, R38, R48, R50, R51, R53: 22K; Resistor (0402)
R40: 150R; Resistor (0402)
R43, R45: 27R; Resistor (0402)
S1: RP Reset; TACT-SIDE-4623
S2: ESP Reset; TACT-SIDE-4623
S3: ESP Ctrl; TACT-SIDE-4623
S4: RP Boot; TACT-SIDE-4623
TP1: MS9288_SCL; TestPoint (Pad 1.0x1.0mm)
TP2: MS9288_SDA; TestPoint (Pad 1.0x1.0mm)
U1: SN74CBT3257CDR; SOP-16
U2: CH340C; SOP-16
U3: NCP1117 3.3; SOT-223
U4: USBLC6-2SC6; SOT-23-6
U5: ESP32-WROVER-E
U6: AMS1117-3.3; SOT-223
U7: AMS1117-1.8; SOT-223
U8: MS9288A; QFN 48
U9: W25Q128JVSIQ; SOIC-8
U10: RP2040; QFN 56
U11, U13: TS3USB221RSER; UQFN-10
U12: MW7211A; SOP-16
X1: 24.576 MHz; Crystal (2520)
X2: 12 MHz; Crystal (3225)

Connections:
+3V3: C6.1, C8.1, C9.1, C40.2, C48.1, C49.1, C50.1, C51.1, C52.1, C53.1, C54.1, C55.1, C57.1, C58.1, C62.2, C64.2, J5.P4 (VDD), J6.4 (VDD), R2.2, R3.2, R13.2, R33.1, R34.1, R36.1, R37.1, R48.1, R49.1, R51.1, R52.1, R54.1, R55.1, U3.2 (VO), U5.2 (3V3), U9.8 (VCC), U10.1 (IOVDD), U10.10 (IOVDD), U10.22 (IOVDD), U10.33 (IOVDD), U10.42 (IOVDD), U10.43 (ADC_AVDD), U10.44 (VREG_IN), U10.48 (USB_VDD), U10.49 (IOVDD), U11.10 (VCC), U13.10 (VCC)
/Audio Out/A_OUT: C41.1, J7.R, J7.T
/DAT1: J5.P8 (DAT1), J6.8 (DAT1)
/DAT2: J5.P1 (DAT2), J6.1 (DAT2)
/ESP_EN: C2.1, JP2.2 (B), Q1.3 (C), R2.1, S2.2, U5.3 (EN/CHIP_PU)
/ESP_IO0: Q2.3 (C), U5.25 (GPIO0/BOOT/ADC2_CH1)
/ESP_IO1: LD2.1 (K), U2.3 (RxD), U5.35 (U0TXD/GPIO1)
/ESP_IO2: J5.P7 (DAT0), J6.7 (DAT0), U5.24 (ADC2_CH2/GPIO2)
/ESP_IO3: LD1.1 (K), U2.2 (TxD), U5.34 (U0RXD/GPIO3)
/ESP_IO4: R14.1, U5.26 (ADC2_CH0/GPIO4)
/ESP_IO5: R15.1, U5.29 (GPIO5)
/ESP_IO12: J5.P3 (CMD), J6.3 (CMD), U5.14 (MTDI/GPIO12/ADC2_CH5)
/ESP_IO13: J5.P2 (CD/DAT3), J6.2 (DAT3/CD), U5.16 (MTCK/GPIO13/ADC2_CH4)
/ESP_IO14: J5.P5 (CLK), J6.5 (CLK), U5.13 (MTMS/GPIO14/ADC2_CH6)
/ESP_IO15: R24.1, U5.23 (MTDO/GPIO15/ADC2_CH3)
/ESP_IO18: R16.1, U5.30 (GPIO18)
/ESP_IO19: R17.1, U5.31 (GPIO19)
/ESP_IO21: R18.1, U5.33 (GPIO21)
/ESP_IO22: R19.1, U5.36 (GPIO22)
/ESP_IO23: R23.1, U5.37 (GPIO23)
/ESP_IO25: R30.1, R39.1, U5.10 (DAC_1/ADC2_CH8/GPIO25)
/ESP_IO26: U1.9 (3A), U5.11 (DAC_2/ADC2_CH9/GPIO26)
/ESP_IO27: U1.12 (4A), U5.12 (ADC2_CH7/GPIO27)
/ESP_IO32: U1.7 (2A), U5.8 (32K_XP/GPIO32/ADC1_CH4)
/ESP_IO33: U1.4 (1A), U5.9 (32K_XN/GPIO33/ADC1_CH5)
/ESP_IO34: C44.1, C45.1, D1.1, R41.1, R42.1, U5.6 (GPIO34/ADC1_CH6)
/ESP_IO36: C3.1, R3.1, S3.2, U5.4 (SENSOR_VP/GPIO36/ADC1_CH0)
/GPIO2: J2.1, U10.4 (GPIO2)
/GPIO3: J2.2, U10.5 (GPIO3)
/GPIO4: J2.3, U10.6 (GPIO4)
/GPIO5: J2.4, U10.7 (GPIO5)
/GPIO6: J2.6, U10.8 (GPIO6)
/GPIO7: J2.7, U10.9 (GPIO7)
/GPIO8: J2.9, U10.11 (GPIO8)
/GPIO11: U1.6 (2B2), U10.14 (GPIO11)
/GPIO12: U1.3 (1B2), U10.15 (GPIO12)
/GPIO14: U1.13 (4B2), U10.17 (GPIO14)
/GPIO15: U1.10 (3B2), U10.18 (GPIO15)
/GPIO16: JP2.1 (A), U10.27 (GPIO16)
/HUB_D+: U11.3 (2D+), U12.11 (DPU)
/HUB_D-: U11.4 (2D-), U12.10 (DMU)
/KB_CLK: J3.5, Q6.3 (D), R53.2
/KB_CLK_3V: Q6.2 (S), R51.2, U1.2 (1B1)
/KB_DATA: J3.1, Q3.3 (D), R35.2
/KB_DATA_3V: Q3.2 (S), R33.2, U1.5 (2B1)
/MP1_D+: U11.1 (1D+), U13.3 (2D+)
/MP1_D-: U11.2 (1D-), U13.4 (2D-)
/MS_CLK: J9.5, Q4.3 (D), R38.2
/MS_CLK_3V: Q4.2 (S), R36.2, U1.11 (3B1)
/MS_DATA: J9.1, Q5.3 (D), R50.2
/MS_DATA_3V: Q5.2 (S), R48.2, U1.14 (4B1)
/PW_D+: U4.4 (I/O2), U13.8 (D+)
/PW_D-: U4.6 (I/O1), U13.7 (D-)
/RP2040/GPIO25: R47.2, U10.37 (GPIO25)
/RP2040/QSPI_SCLK: U9.6 (CLK), U10.52 (QSPI_SCLK)
/RP2040/QSPI_SD0: U9.5 (DI(IO0)), U10.53 (QSPI_SD0)
/RP2040/QSPI_SD1: U9.2 (DO(IO1)), U10.55 (QSPI_SD1)
/RP2040/QSPI_SD2: U9.3 (IO2), U10.54 (QSPI_SD2)
/RP2040/QSPI_SD3: U9.7 (IO3), U10.51 (QSPI_SD3)
/RP2040/QSPI_SS: R44.1, U9.1 (~CS), U10.56 (QSPI_SS)
/RP2040/XIN: C60.1, U10.20 (XIN), X2.1
/RP2040/XOUT: R46.1, U10.21 (XOUT)
/RP_D+: R43.1, U11.8 (D+)
/RP_D-: R45.1, U11.7 (D-)
/RUN: S1.1, U10.26 (RUN)
/SN74_S: JP1.1, R1.2, U1.1 (S)
/Tape In/G: C43.2, J8.S
/Tape In/L: C44.2, J8.T
/Tape In/R: C45.2, J8.R
/UMSW1: JP1.2, R55.2, U13.9 (S)
/UMSW2: JP1.3, R54.2, U11.9 (S)
/USB1_D1+: R56.1, U12.8 (DP3)
/USB1_D1-: R58.1, U12.7 (DM3)
/USB1_D2+: R57.1, U12.6 (DP2)
/USB1_D2-: R59.1, U12.5 (DM2)
/UTC_D+: U2.5 (D+), U13.1 (1D+)
/UTC_D-: U2.6 (D-), U13.2 (1D-)
/VGA to HDMI/5V: R28.2, R29.2
/VGA to HDMI/ALIN: C38.1, U8.30 (ALIN)
/VGA to HDMI/AMS_1V8: C16.1, C25.1, C26.1, FB2.1, U7.2 (VO), U8.7 (AVDD18), U8.16 (AVDD18), U8.21 (AVDD18)
/VGA to HDMI/AMS_1V8A: C14.1, C15.1, C28.1, FB2.2, U8.1 (AVDD18_ADC), U8.41 (AVDD18_ADC), U8.46 (AVDD18_ADC)
/VGA to HDMI/AMS_3V3: C18.1, C21.1, C22.1, FB1.2, U6.2 (VO), U8.5 (DVDD33), U8.11 (DVDD33), U8.24 (DVDD33), U8.36 (DVDD33)
/VGA to HDMI/AMS_3V3A: C12.1, C17.1, FB1.1, U8.12 (AVDD33), U8.38 (AVDD33), U8.43 (AVDD33), U8.47 (AVDD33)
/VGA to HDMI/ARIN: C39.1, U8.33 (ARIN)
/VGA to HDMI/B: C13.1, U8.39 (B/Pb)
/VGA to HDMI/DCCSCL: J4.15 (SCL), R25.1, U8.10 (DCCSCL)
/VGA to HDMI/DDCSDA: J4.16 (SDA), R26.1, U8.9 (DDCSDA)
/VGA to HDMI/G: C19.1, U8.44 (G/Y)
/VGA to HDMI/HDMI_5V: J4.18 (+5V), R25.2, R26.2
/VGA to HDMI/HPDT: J4.19 (HOT_PLUG_DET), U8.8 (HotPlugDetect)
/VGA to HDMI/R: C23.1, U8.48 (R/Pr)
/VGA to HDMI/SCL: R28.1, TP1.1, U8.28 (SCL)
/VGA to HDMI/SDA: R29.1, TP2.1, U8.29 (SDA)
/VGA to HDMI/SOG_G: C19.2, C27.2, R16.2, R17.2, R21.1
/VGA to HDMI/TMDS_CLK+: J4.10 (CLKP), U8.15 (TMDS_CLK+)
/VGA to HDMI/TMDS_CLK-: J4.12 (CLKN), U8.14 (TMDS_CLK-)
/VGA to HDMI/TMDS_D0+: J4.7 (D0P), U8.18 (TMDS-D0+)
/VGA to HDMI/TMDS_D0-: J4.9 (D0N), U8.17 (TMDS_D0-)
/VGA to HDMI/TMDS_D1+: J4.4 (D1P), U8.20 (TMDS_D1+)
/VGA to HDMI/TMDS_D1-: J4.6 (D1N), U8.19 (TMDS_D1-)
/VGA to HDMI/TMDS_D2+: J4.1 (D2P), U8.23 (TMDS_D2+)
/VGA to HDMI/TMDS_D2-: J4.3 (D2N), U8.22 (TMDS_D2-)
GND: C1.1, C2.2, C3.2, C4.2, C5.2, C6.2, C7.2, C8.2, C9.2, C10.2, C11.2, C12.2, C14.2, C15.2, C16.2, C17.2, C18.2, C20.2, C21.2, C22.2, C24.2, C25.2, C26.2, C28.2, C29.2, C30.2, C31.2, C32.2, C33.2, C34.2, C35.2, C36.2, C37.2, C40.1, C42.1, C43.1, C46.2, C47.2, C48.2, C49.2, C50.2, C51.2, C52.2, C53.2, C54.2, C55.2, C56.2, C57.2, C58.2, C59.2, C60.2, C61.2, C62.1, C63.2, C64.1, C65.2, C66.2, D1.2, J1.1 (GND), J1.12 (GND), J2.8, J3.3, J4.2 (G_D2), J4.5 (G_D1), J4.8 (G_D0), J4.11 (G_CLK), J4.17 (G_DDC/CEC), J4.20 (SHIELD1), J4.21 (SHIELD2), J4.22 (SHIELD3), J4.23 (SHIELD4), J5.G1 (GND_1), J5.G2 (GND_2), J5.G3 (GND_3), J5.P6 (VSS), J6.6 (VSS), J7.S, J9.3, J10.4 (GND1), J10.8 (GND2), J10.9 (Shield), JP1.4, JP1.5, LD3.1 (K), LD4.1 (K), R1.1, R8.1, R11.1, R12.2, R20.2, R21.2, R22.2, R27.1, R32.2, R40.1, R41.2, S1.2, S2.1, S3.1, S4.2, U1.8 (GND), U1.15 (~OE), U2.1 (GND), U3.1 (GND), U4.2 (GND), U5.1 (GND), U5.15 (GND), U5.38 (GND), U5.39 (GND_THERMAL), U6.1 (GND), U7.1 (GND), U8.2 (GND), U8.6 (GND), U8.27 (GND), U8.40 (GND), U8.45 (GND), U8.49 (EP), U9.4 (GND), U10.19 (TESTEN), U10.57 (GND), U11.5 (GND), U11.6 (~OE), U12.15 (GND), U12.16 (GND), U13.5 (GND), U13.6 (~OE), X1.2 (GND), X1.4 (GND), X2.2, X2.4
unnamed: C13.2, R14.2, R15.2, R22.1
unnamed: C23.2, R18.2, R19.2, R20.1
unnamed: C37.1, R30.2, R31.1
unnamed: C38.2, C39.2, R31.2, R32.1
unnamed: C41.2, C42.2, R39.2, R40.2
unnamed: C59.1, R46.2, X2.3
unnamed: J1.4 (CC1), R8.2
unnamed: J1.10 (CC2), R11.2
unnamed: J1.5 (DN2), J1.7 (DN1), R9.2
unnamed: J1.6 (DP1), J1.8 (DP2), R10.2
unnamed: J1.13 (SHIELD), R12.1
unnamed: J10.3 (D1+), R56.2
unnamed: J10.2 (D1-), R58.2
unnamed: J10.7 (D2+), R57.2
unnamed: J10.6 (D2-), R59.2
unnamed: LD1.2 (A), R4.1
unnamed: LD2.2 (A), R5.2
unnamed: LD3.2 (A), R13.1
unnamed: LD4.2 (A), R47.1
unnamed: Q1.1 (B), R6.1
unnamed: Q1.2 (E), R7.2, U2.14 (RTS)
unnamed: Q2.1 (B), R7.1
unnamed: Q2.2 (E), R6.2, U2.13 (DTR)
unnamed: Q3.1 (G), R34.2
unnamed: Q4.1 (G), R37.2
unnamed: Q5.1 (G), R49.2
unnamed: Q6.1 (G), R52.2
unnamed: R9.1, U4.1 (I/O1)
unnamed: R10.1, U4.3 (I/O2)
unnamed: R44.2, S4.1
unnamed: C5.1, U2.4 (3V)
unnamed: R23.2, U8.34 (HSIN)
unnamed: C33.1, C34.1, U8.37 (REFP)
unnamed: C29.1, C30.1, U8.31 (REFQ0)
unnamed: C31.1, C32.1, U8.32 (REFQ1)
unnamed: C27.1, U8.42 (SOG/Y)
unnamed: R27.2, U8.13 (SWREF1k)
unnamed: R24.2, U8.35 (VSIN)
unnamed: C36.1, U8.25 (XTI), X1.1 (OSC)
unnamed: C35.1, U8.26 (XTO), X1.3 (OSC)
unnamed: R45.2, U10.46 (USB_DM)
unnamed: R43.2, U10.47 (USB_DP)
unnamed: C46.1, C47.1, C56.1, U10.23 (DVDD), U10.45 (VREG_VOUT), U10.50 (DVDD)
unnamed: U12.12 (VD33), U12.14 (VD3)
VBUS: C1.2, C4.1, C7.1, C10.1, C11.1, C20.1, C24.1, C61.1, C63.1, C65.1, C66.1, J1.2 (VBUS), J1.11 (VBUS), J2.5, J3.4, J9.4, J10.1 (VBUS1), J10.5 (VBUS2), JP1.6, R4.2, R5.1, R35.1, R38.1, R42.2, R50.1, R53.1, U1.16 (VCC), U2.16 (VCC), U3.3 (VI), U4.5 (VBUS), U6.3 (VI), U7.3 (VI), U12.13 (VDD5)
